hkzlab/CGA_Schematics/README.md

# IBM Colour Graphics Adapter (CGA) Schematics

This is a redrawing in KiCad of the original IBM CGA card schematics.
I intend to use these to help me repair original boards and build a clone.

IBM CGA

Original picture under CC BY-SA 4.0, found [here](https://en.wikipedia.org/wiki/Color_Graphics_Adapter#/media/File:IBM_Color_Graphics_Adapter.jpg)

## WARNING

**Help in double checking** and finding issues is appreciated: you can find the original manual [here](docs/Color_Graphics_Adapter_-_Manual.pdf), 
see pages 32-37.

I used this schematic with kicad to build a clone (CGA Redux), which apparently works fine.
