hkzlab/CGA_Schematics/ISA_CGA.pdf

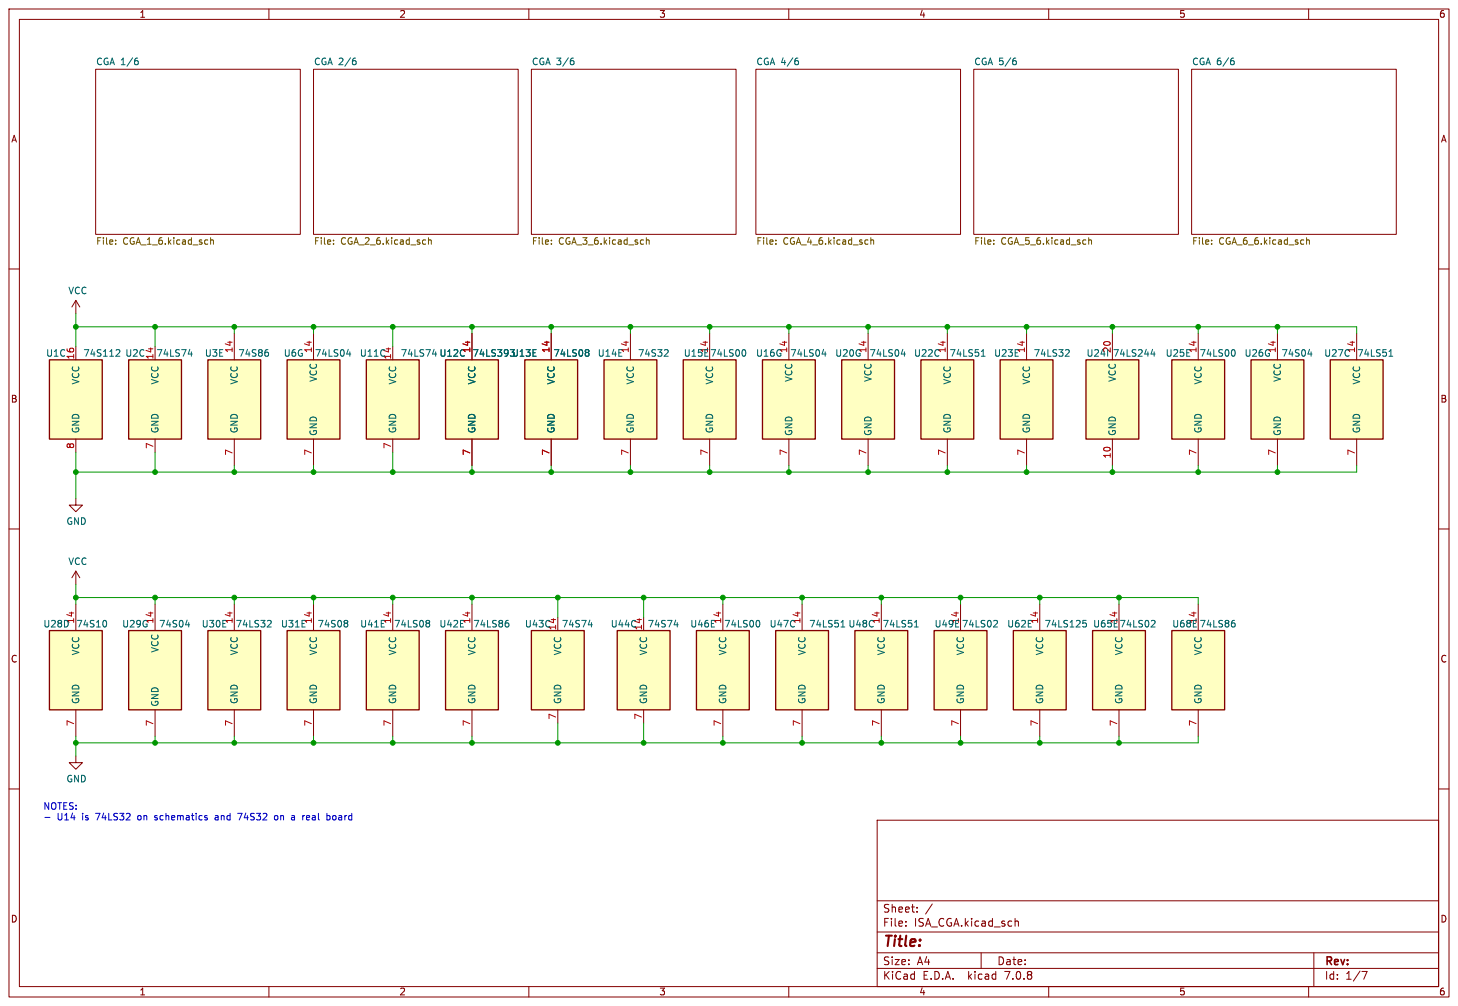
[picture p1: page 1]

7 U25E 74LS00 GND 10 VCC 20 U24I 74LS244 VCC 14 GND

7 U42E 74LS86 NOTES: - U14 is 74LS32 on schematics and 74S32 on a real board

Id: 1/7 Title: File: ISA_CGA.kicad_sch Sheet: /

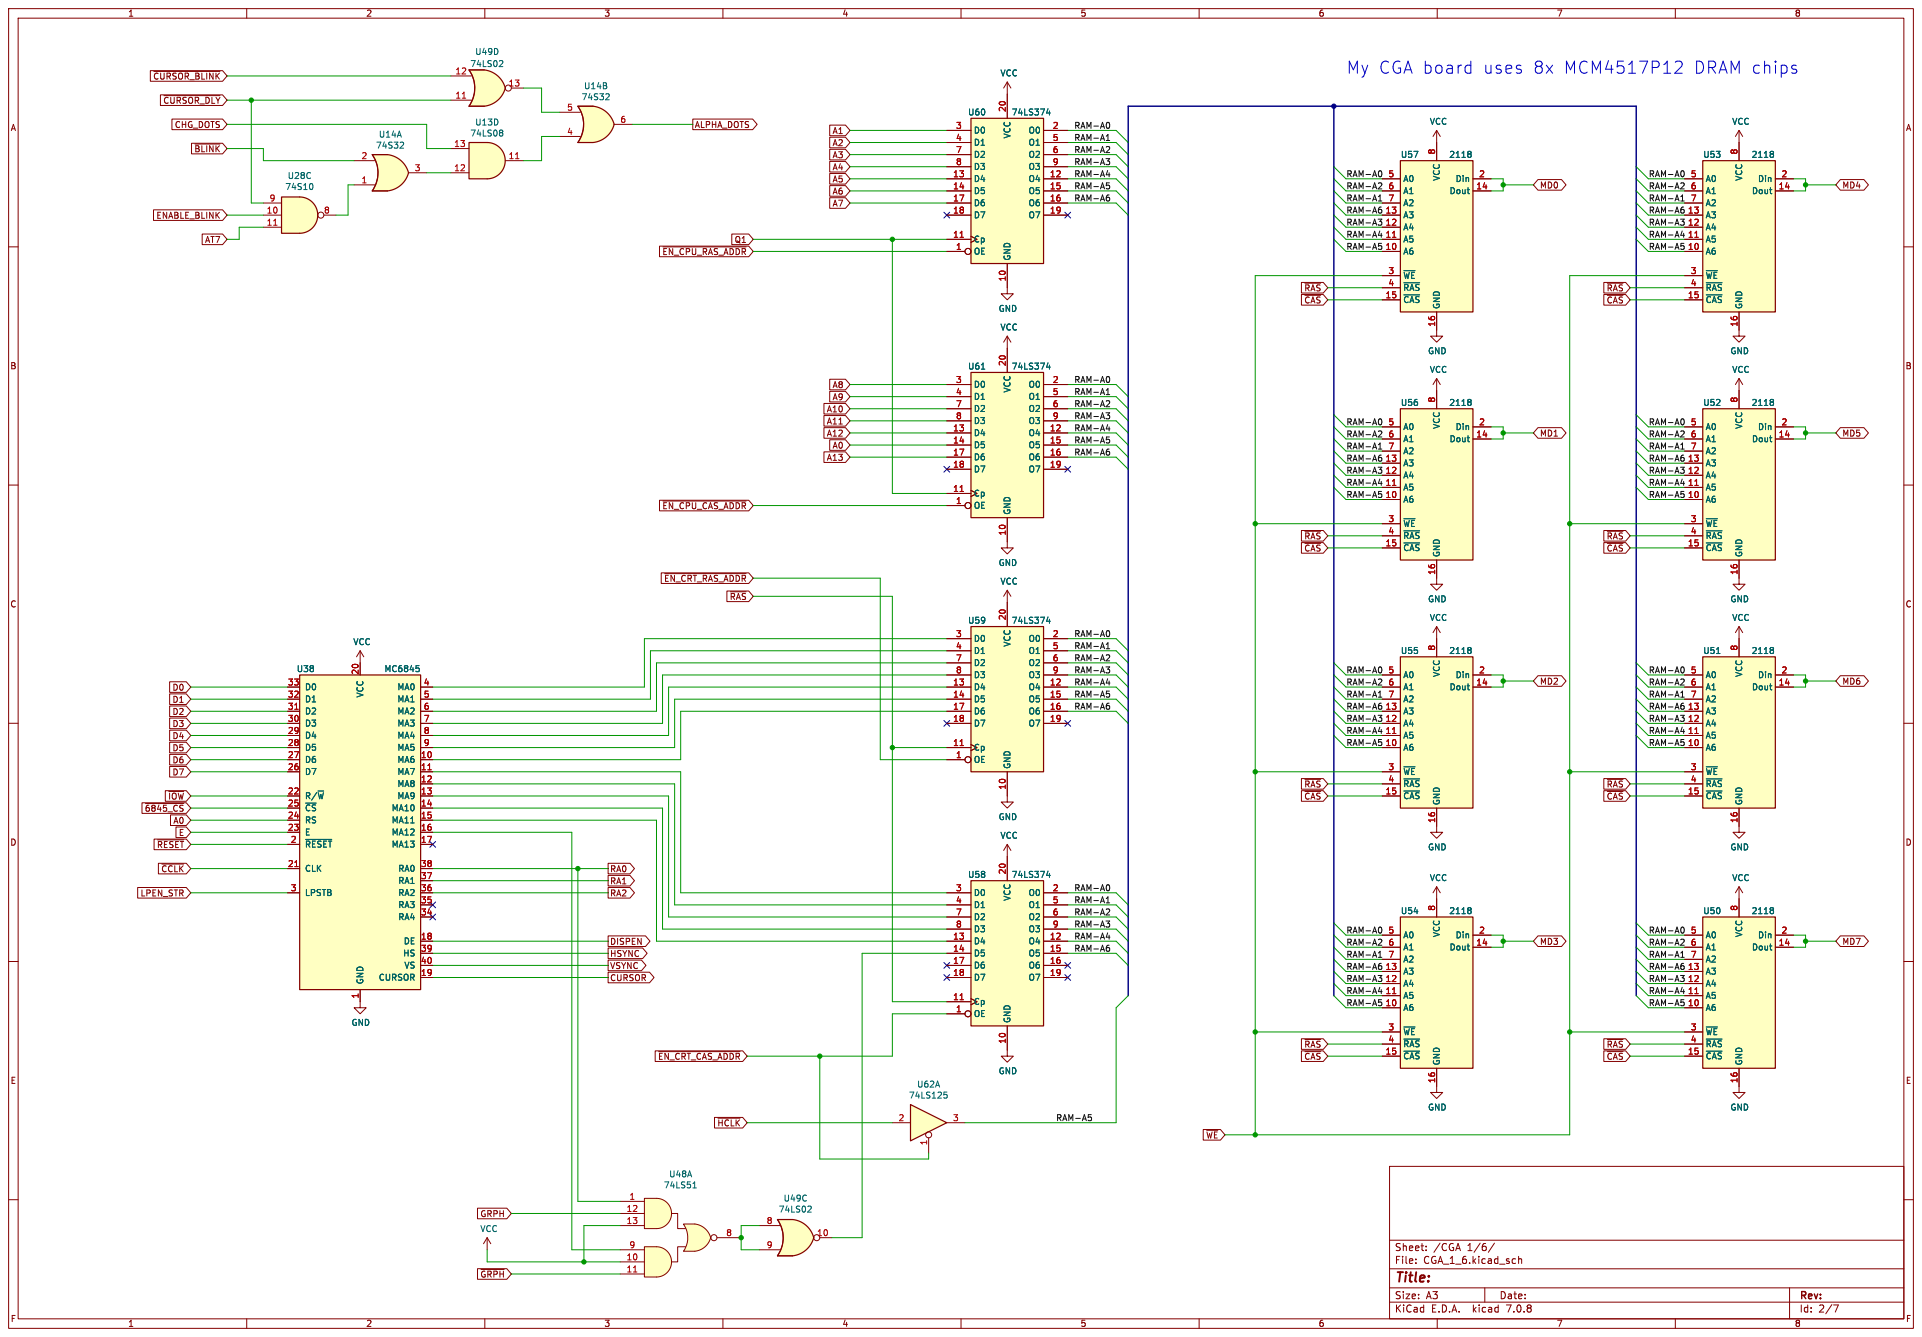
[picture p2: page 2]

RAM-A0 RAM-A2 RAM-A5 RAM-A4

RAM-A3 RAM-A4 RAM-A1 RAM-A6 RAM-A0 RAM-A3

Id: 2/7 Title: File: CGA_1_6.kicad_sch Sheet: /CGA 1/6/

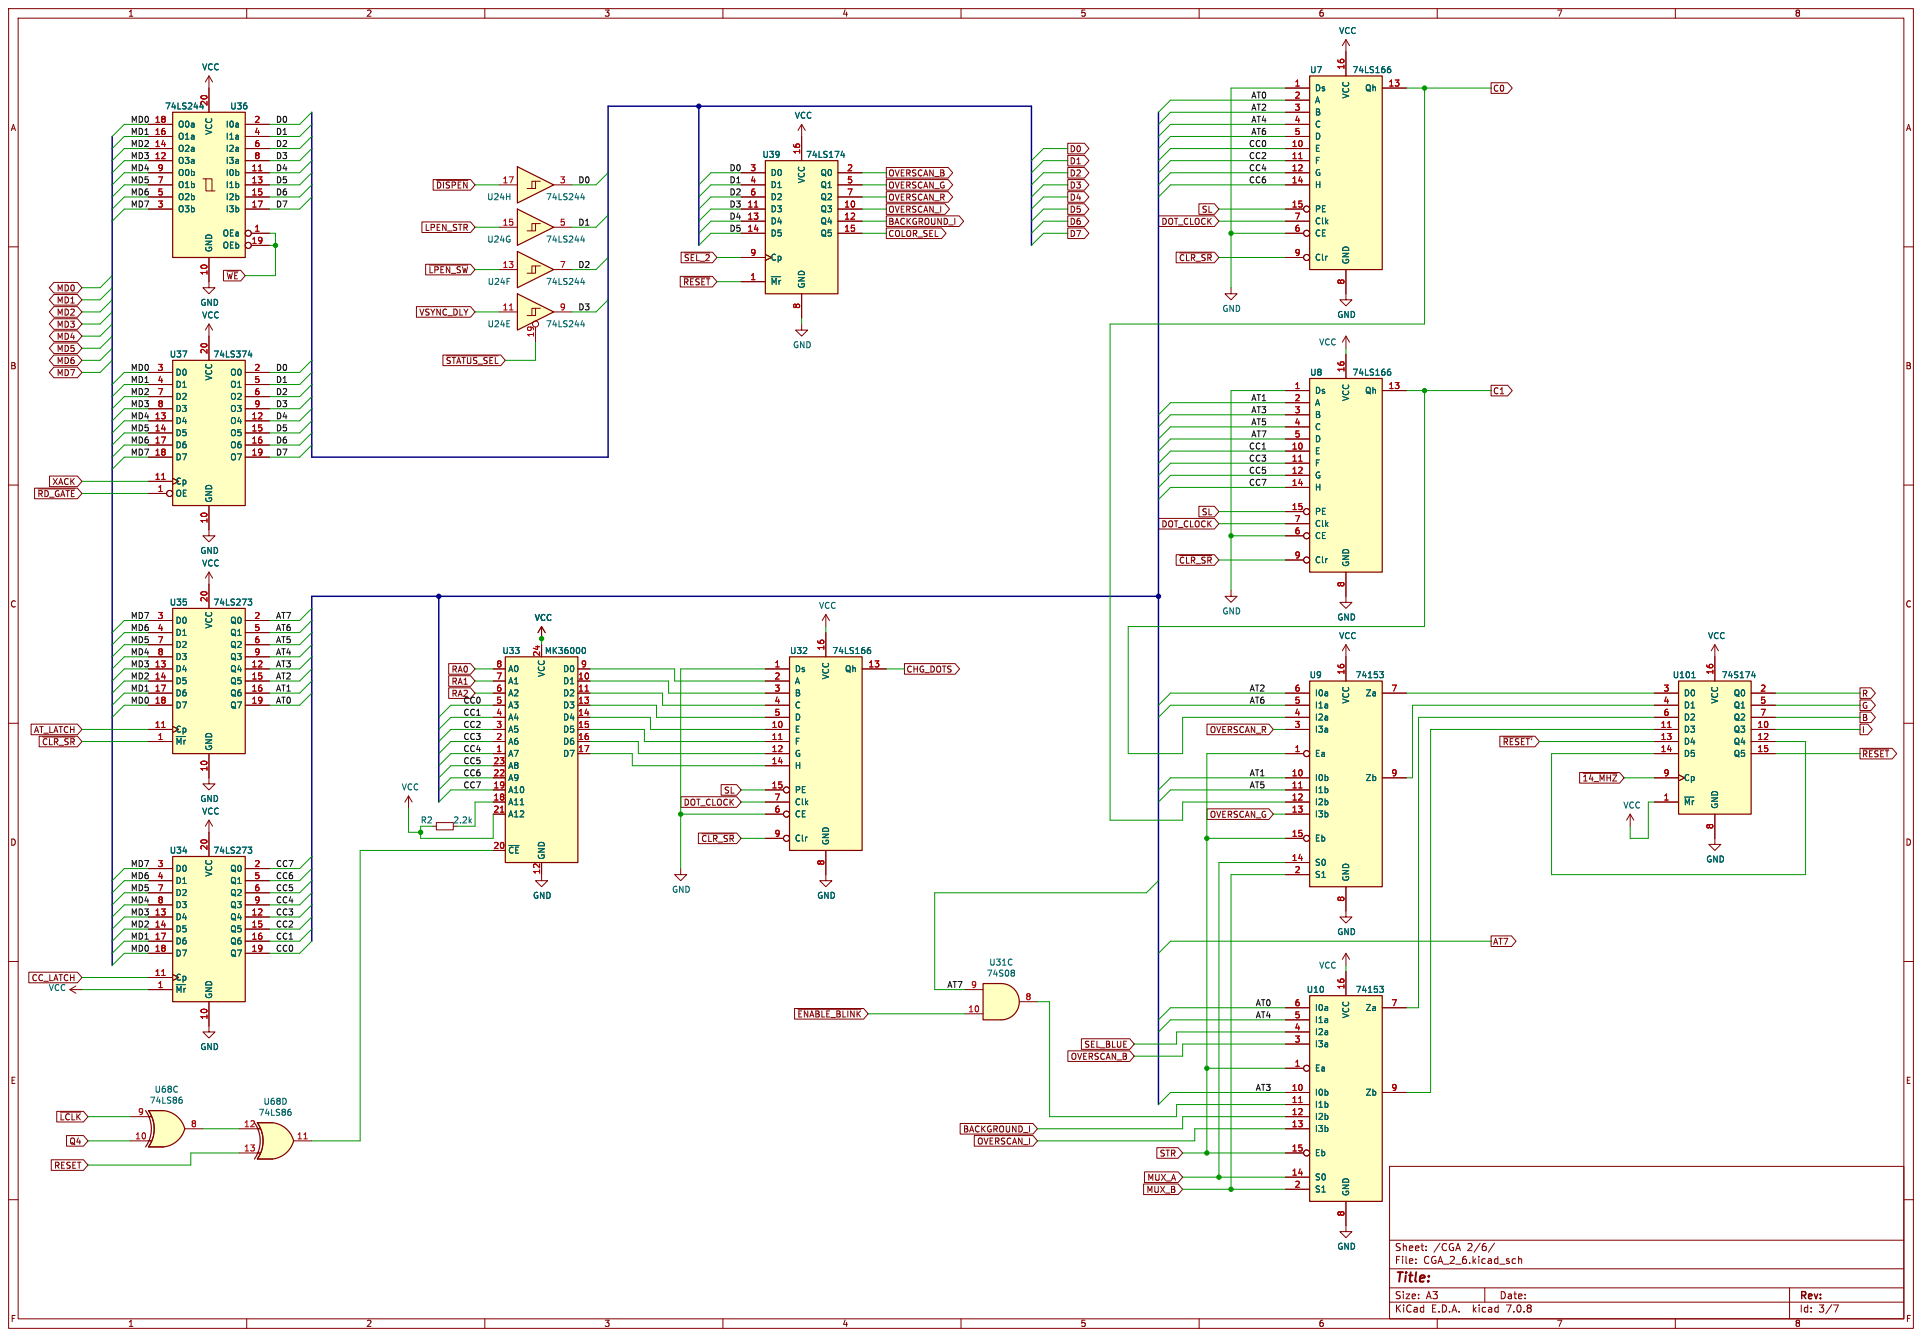
[picture p3: page 3]

Id: 3/7 Title: File: CGA_2_6.kicad_sch Sheet: /CGA 2/6/

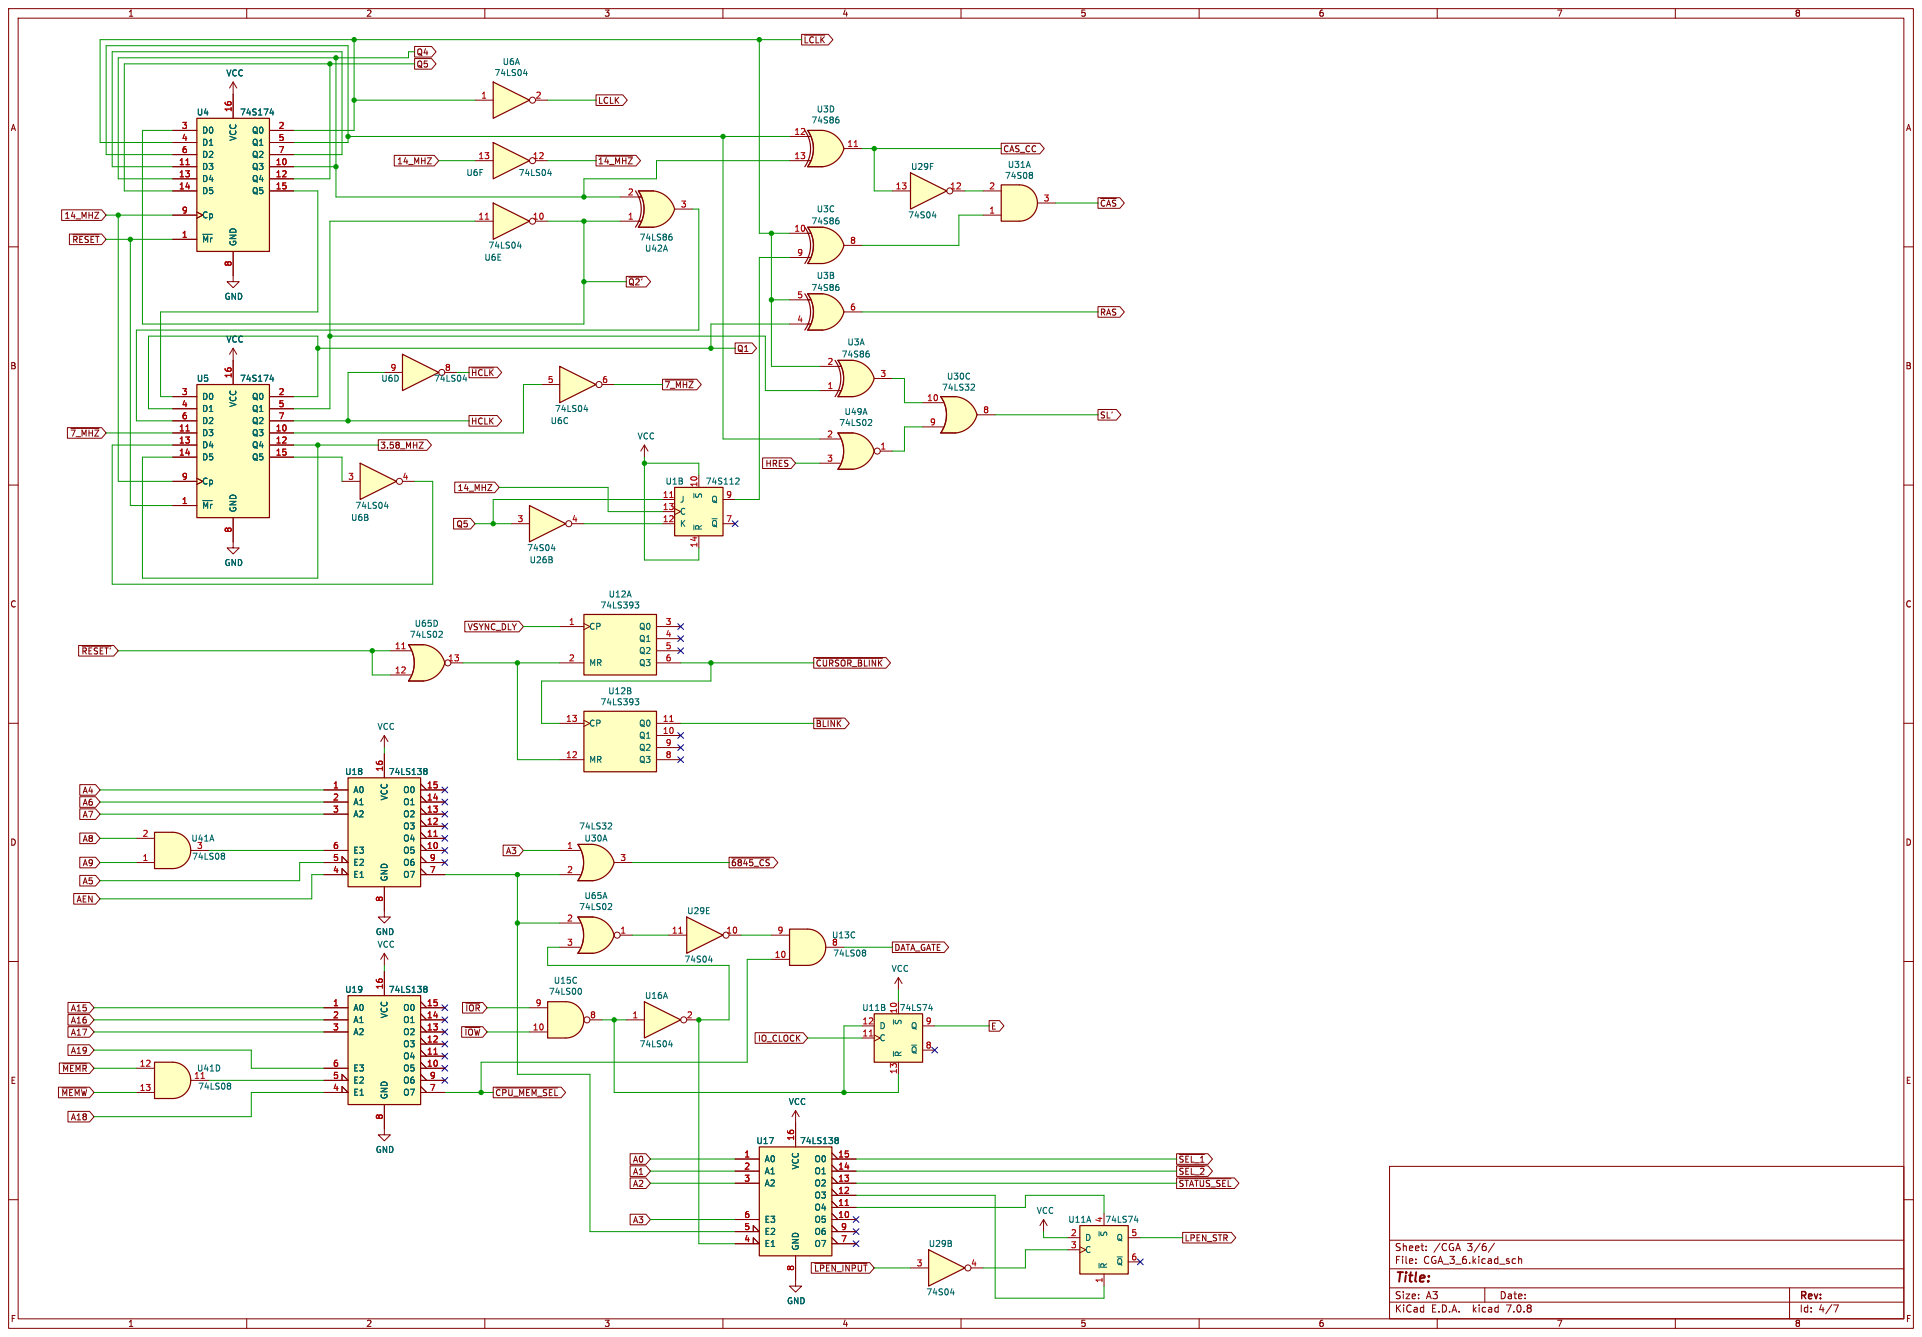
[picture p4: page 4]

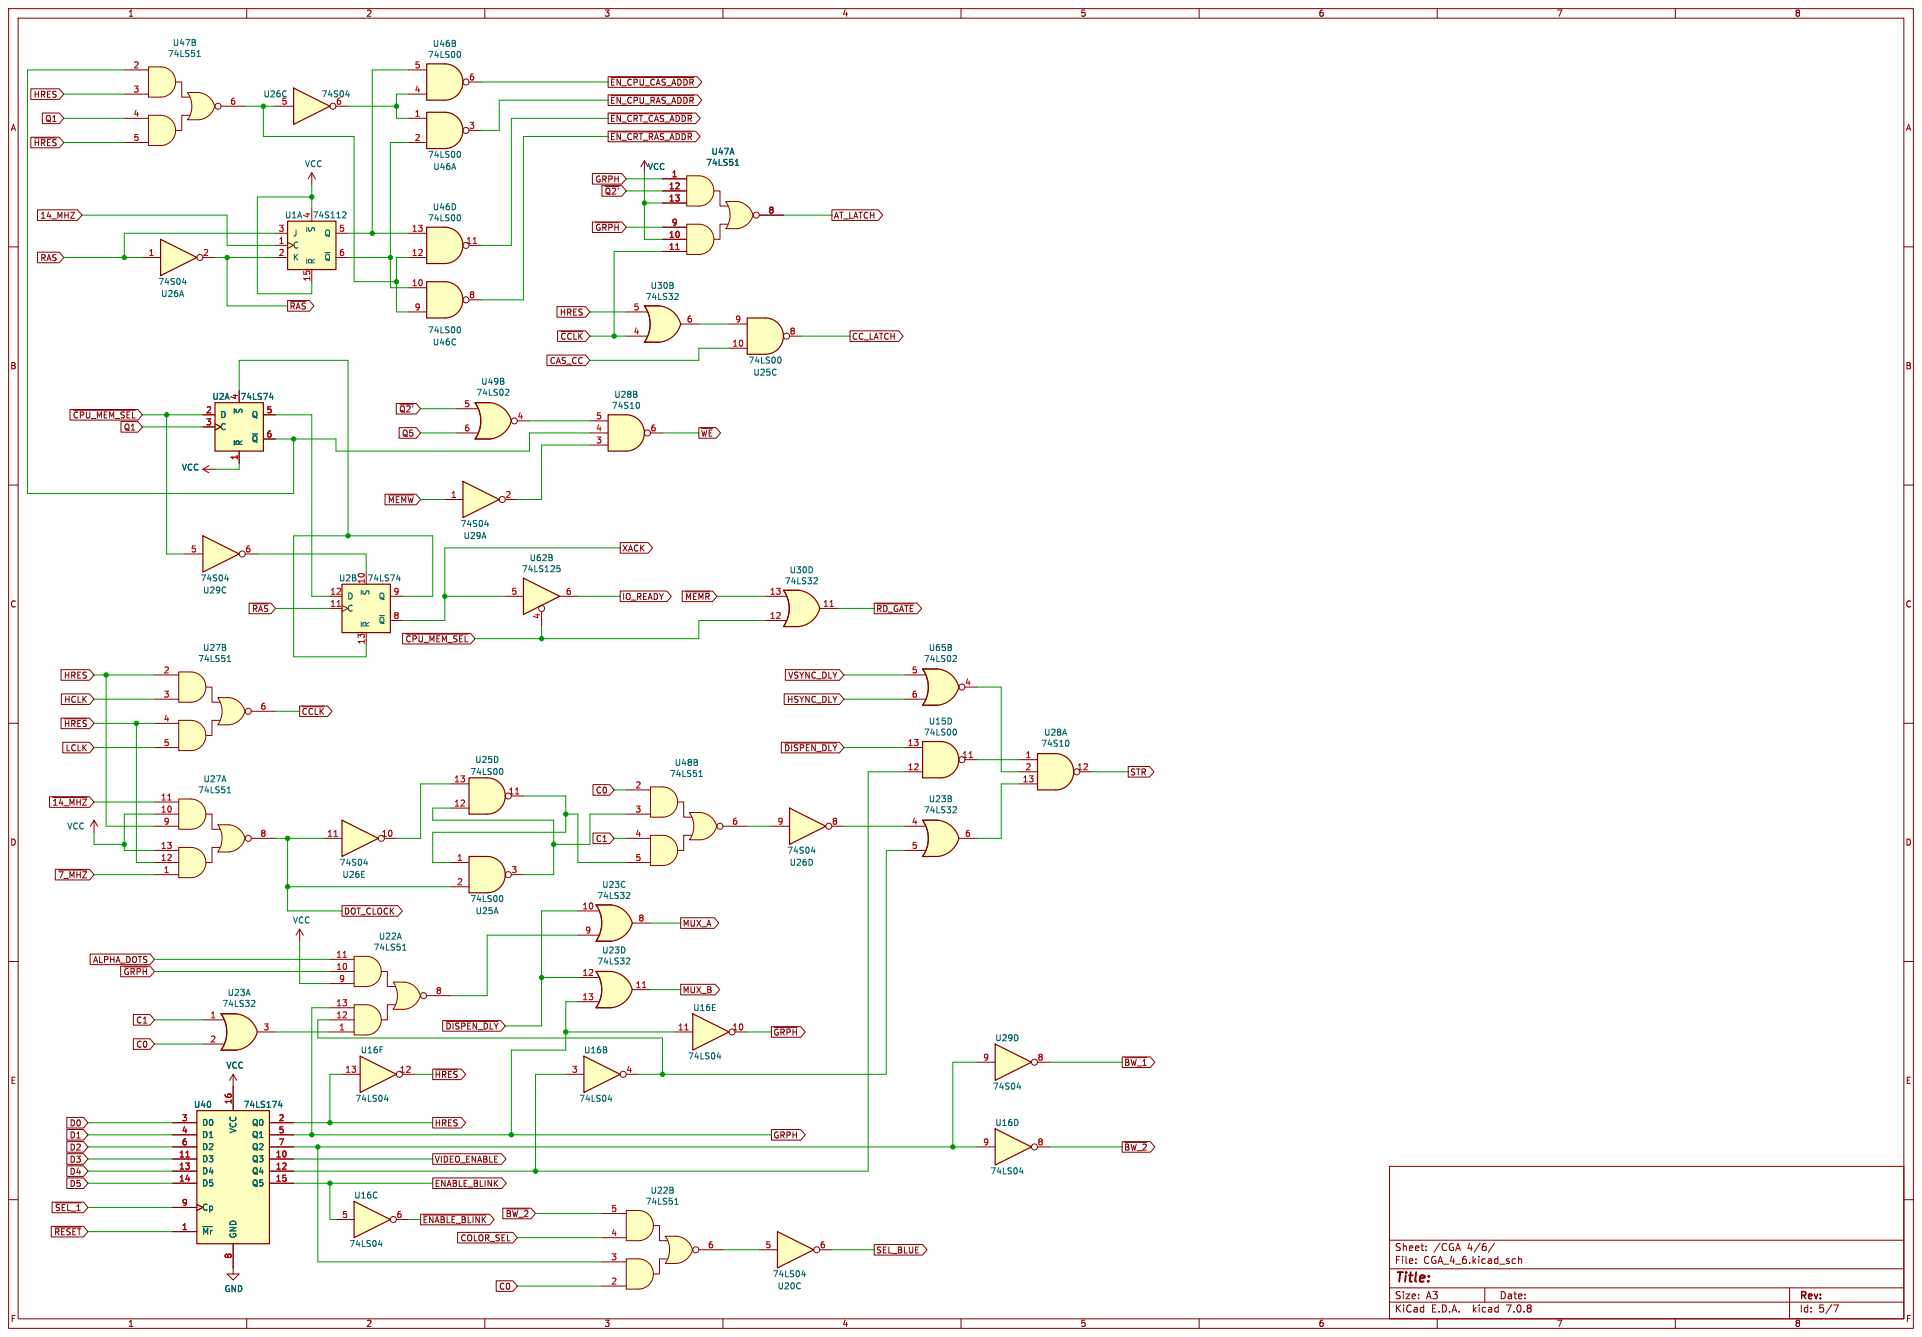
[picture p5: page 5]

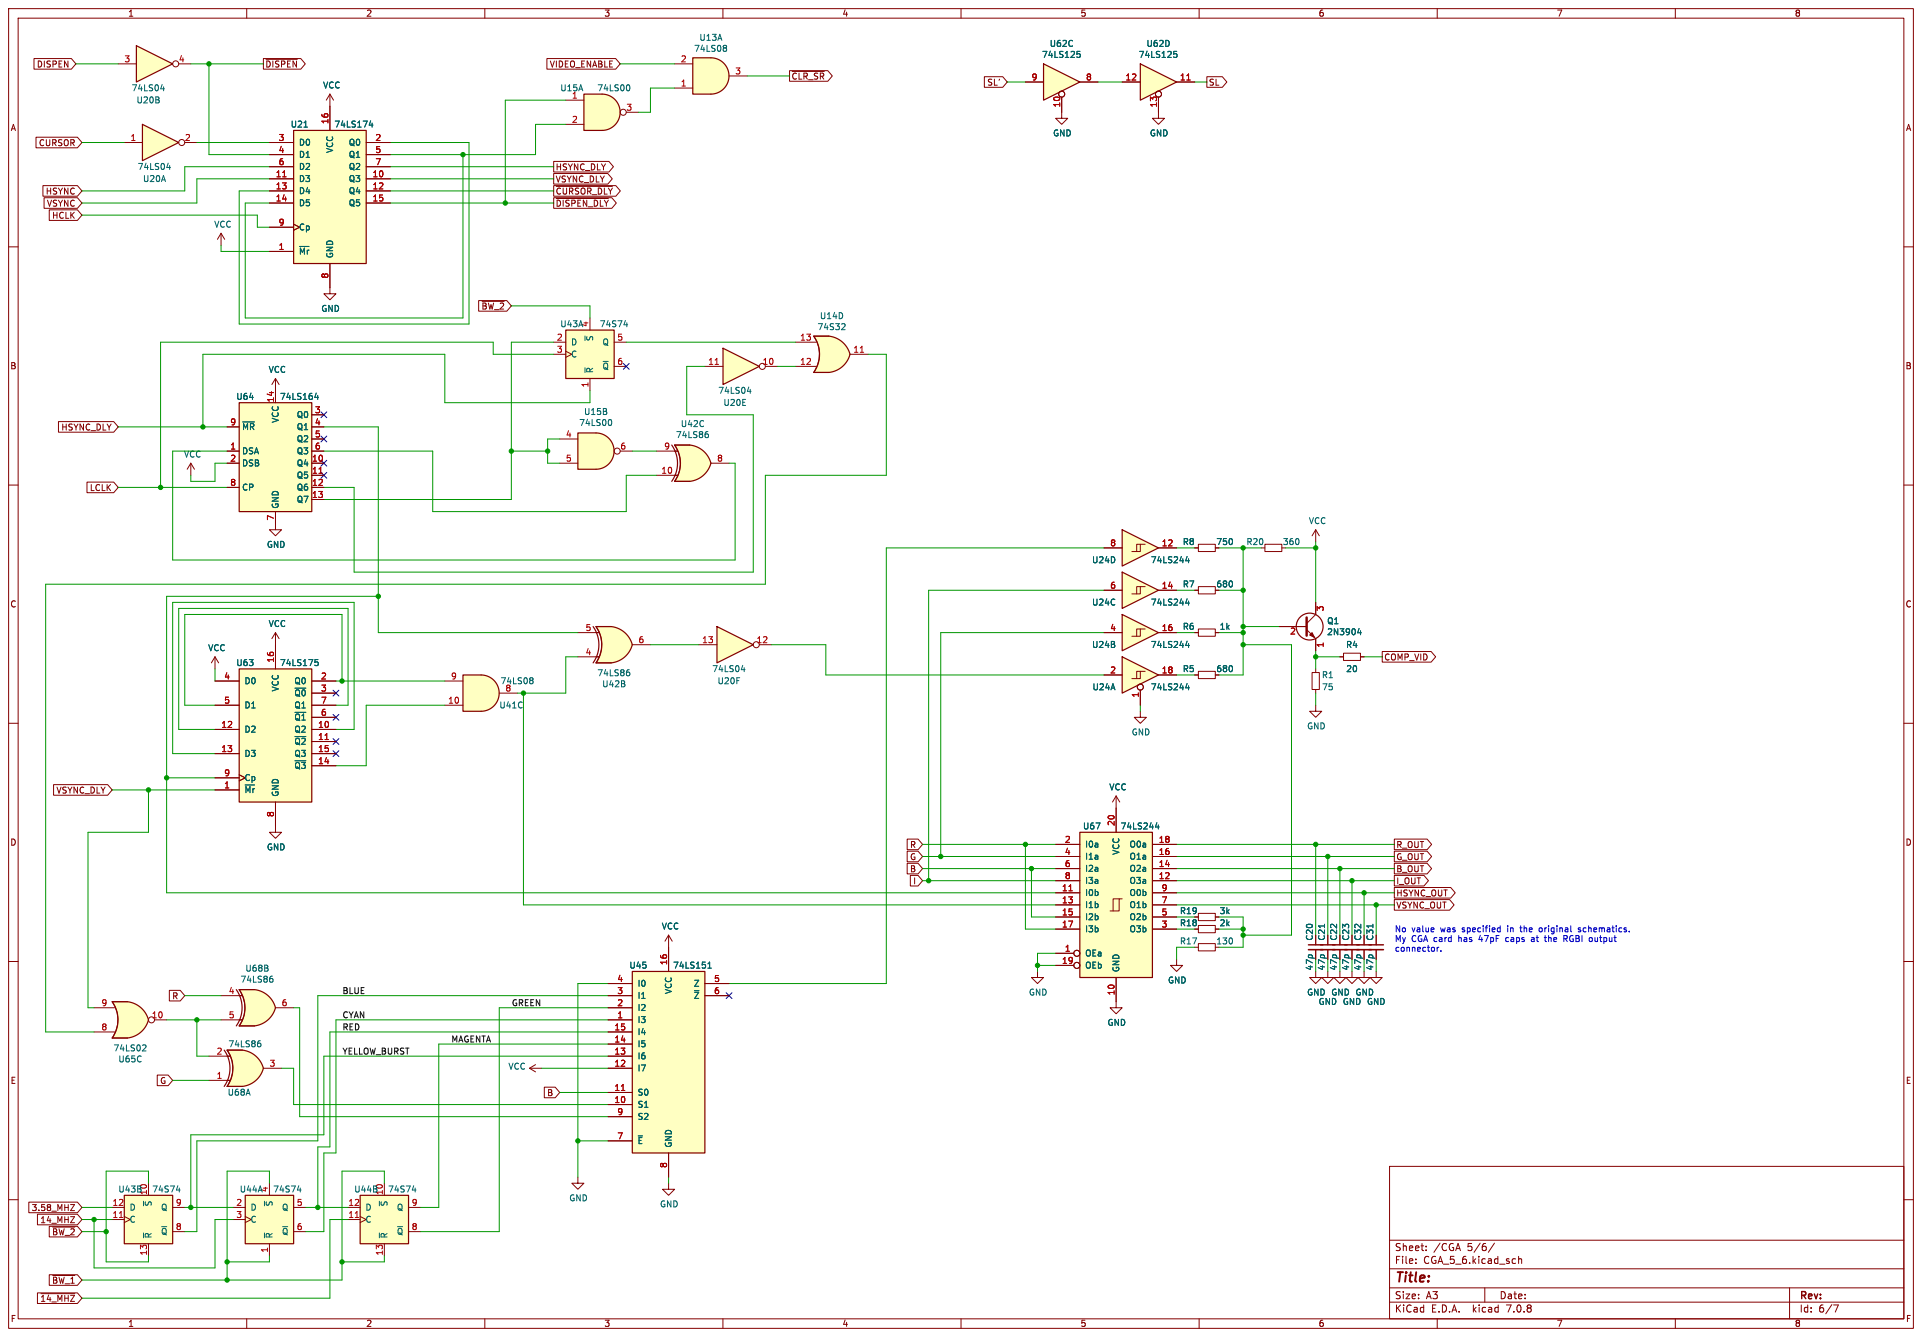
[picture p6: page 6]

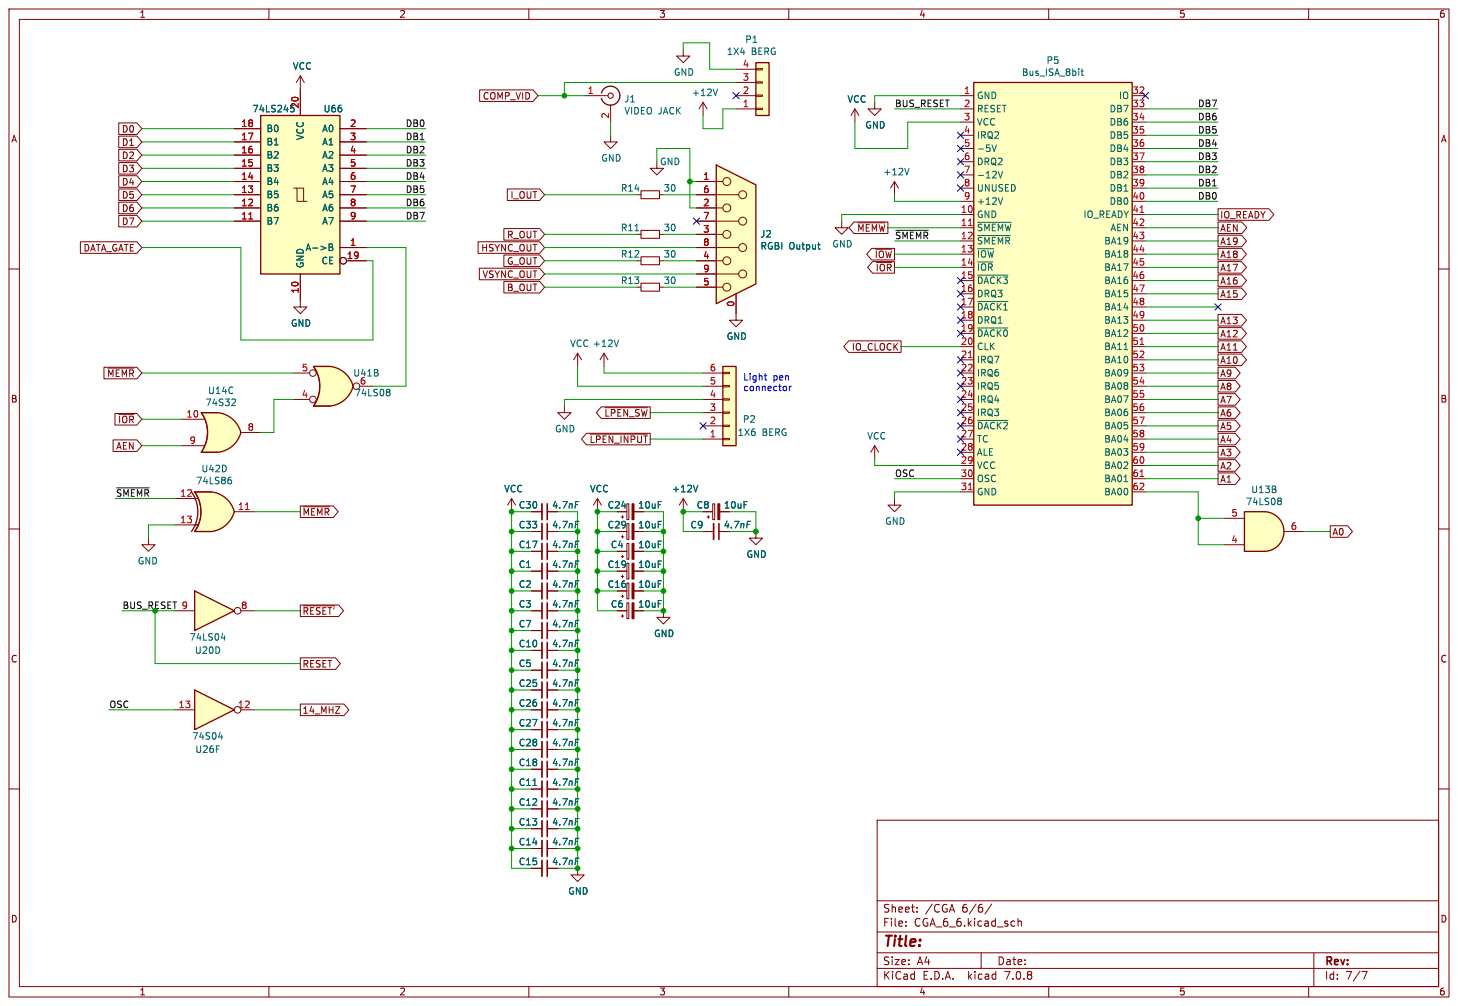
[picture p7: page 7]

Id: 7/7 Title: File: CGA_6_6.kicad_sch Sheet: /CGA 6/6/
