hkzlab/CGA_Schematics/CGA_1_6.kicad_sch

## KiCad design CGA_1_6.kicad_sch (2023-10-13)

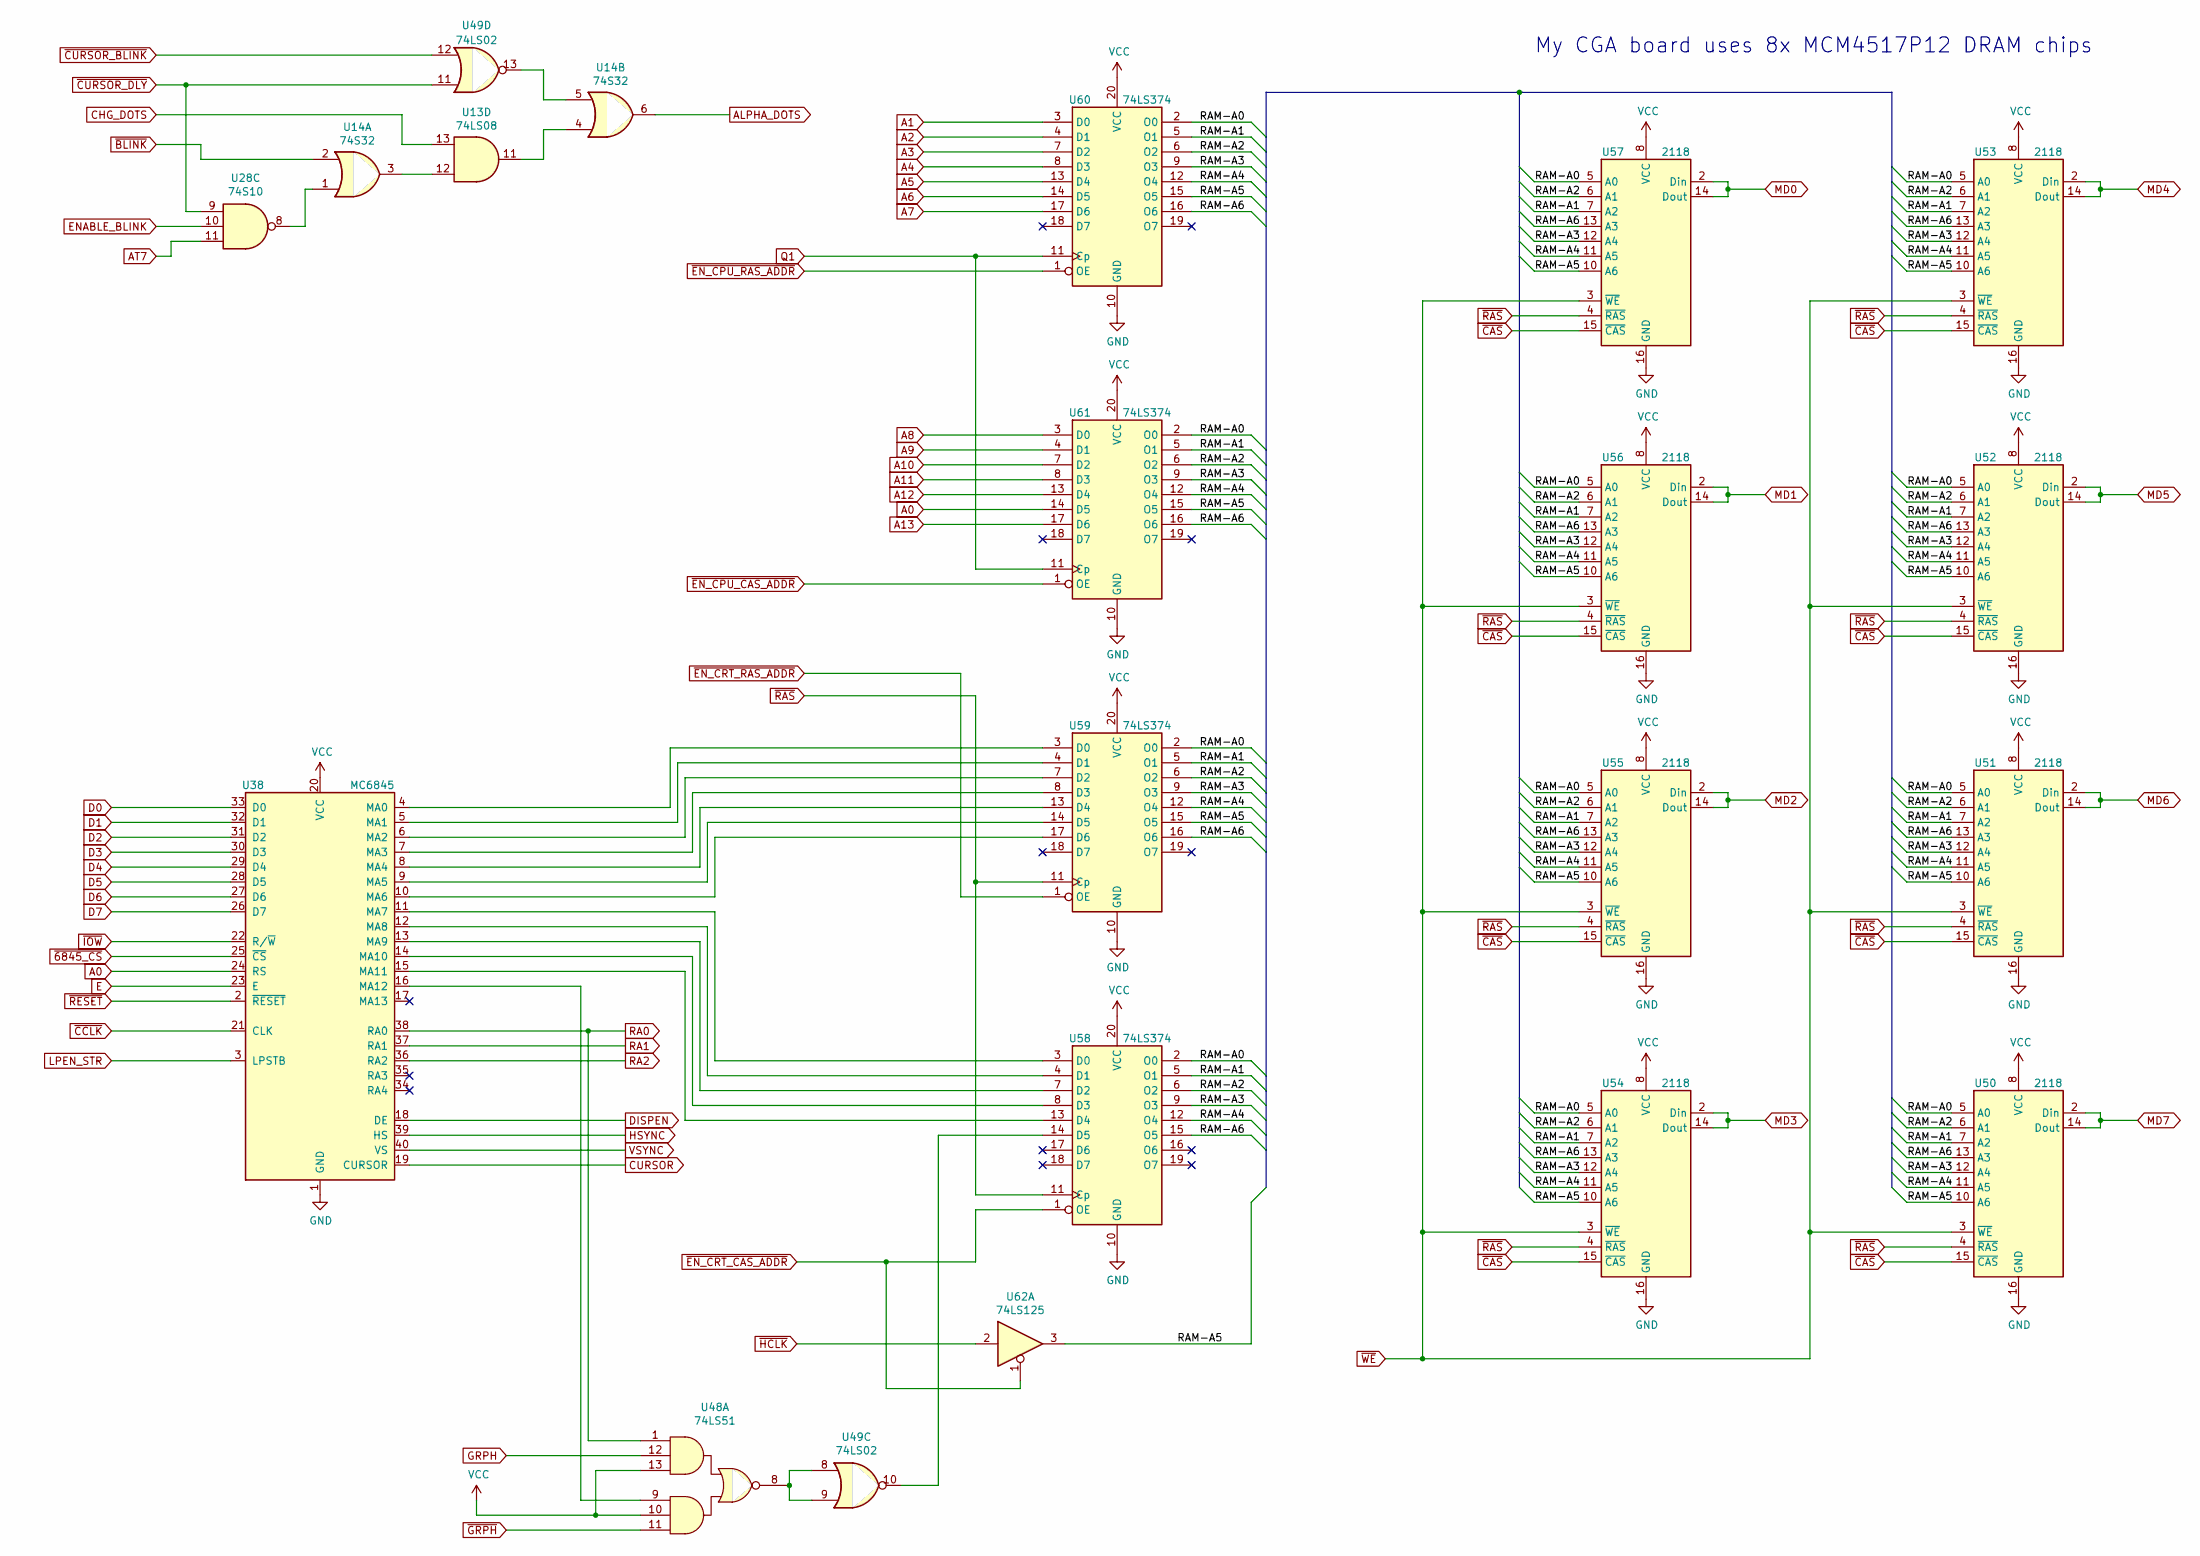
[picture p8: schematic CGA_1_6.kicad_sch]

Parts:
U13: 74LS08; DIP-14_W7.62mm_LongPads
U14: 74S32; DIP-14_W7.62mm_LongPads
U28: 74S10; DIP-14_W7.62mm_LongPads
U38: MC6845; DIP-40_W15.24mm_LongPads
U48: 74LS51; DIP-14_W7.62mm_LongPads
U49: 74LS02
U50, U51, U52, U53, U54, U55, U56, U57: 2118; DIP-16_W7.62mm_LongPads
U58, U59, U60, U61: 74LS374; DIP-20_W7.62mm_LongPads
U62: 74LS125; DIP-14_W7.62mm_LongPads

Connections:
A0: U38.24 (RS), U61.14 (D5)
A1: U60.3 (D0)
A2: U60.4 (D1)
A3: U60.7 (D2)
A4: U60.8 (D3)
A5: U60.13 (D4)
A6: U60.14 (D5)
A7: U60.17 (D6)
A8: U61.3 (D0)
A9: U61.4 (D1)
A10: U61.7 (D2)
A11: U61.8 (D3)
A12: U61.13 (D4)
A13: U61.17 (D6)
ALPHA_DOTS: U14.6
AT7: U28.11
CHG_DOTS: U13.13
CURSOR: U38.19 (CURSOR)
D0: U38.33 (D0)
D1: U38.32 (D1)
D2: U38.31 (D2)
D3: U38.30 (D3)
D4: U38.29 (D4)
D5: U38.28 (D5)
D6: U38.27 (D6)
D7: U38.26 (D7)
DISPEN: U38.18 (DE)
E: U38.23 (E)
ENABLE_BLINK: U28.10
GND: U38.1 (GND), U50.16 (GND), U51.16 (GND), U52.16 (GND), U53.16 (GND), U54.16 (GND), U55.16 (GND), U56.16 (GND), U57.16 (GND), U58.10 (GND), U59.10 (GND), U60.10 (GND), U61.10 (GND)
GRPH: U48.12
HSYNC: U38.39 (HS)
LPEN_STR: U38.3 (LPSTB)
MD0: U57.2 (Din), U57.14 (Dout)
MD1: U56.2 (Din), U56.14 (Dout)
MD2: U55.2 (Din), U55.14 (Dout)
MD3: U54.2 (Din), U54.14 (Dout)
MD4: U53.2 (Din), U53.14 (Dout)
MD5: U52.2 (Din), U52.14 (Dout)
MD6: U51.2 (Din), U51.14 (Dout)
MD7: U50.2 (Din), U50.14 (Dout)
unnamed: U13.11, U14.4
unnamed: U13.12, U14.3
unnamed: U14.1, U28.8
unnamed: U14.5, U49.13
unnamed: U38.4 (MA0), U59.3 (D0)
unnamed: U38.5 (MA1), U59.4 (D1)
unnamed: U38.6 (MA2), U59.7 (D2)
unnamed: U38.7 (MA3), U59.8 (D3)
unnamed: U38.8 (MA4), U59.13 (D4)
unnamed: U38.9 (MA5), U59.14 (D5)
unnamed: U38.10 (MA6), U59.17 (D6)
unnamed: U38.11 (MA7), U58.3 (D0)
unnamed: U38.12 (MA8), U58.4 (D1)
unnamed: U38.13 (MA9), U58.7 (D2)
unnamed: U38.14 (MA10), U58.8 (D3)
unnamed: U38.15 (MA11), U58.13 (D4)
unnamed: U38.16 (MA12), U48.9
unnamed: U48.8, U49.8, U49.9
unnamed: U49.10, U58.14 (D5)
Q1: U60.11 (Cp), U61.11 (Cp)
RA0: U38.38 (RA0), U48.1
RA1: U38.37 (RA1)
RA2: U38.36 (RA2)
RAM-A0: U50.5 (A0), U51.5 (A0), U52.5 (A0), U53.5 (A0), U54.5 (A0), U55.5 (A0), U56.5 (A0), U57.5 (A0), U58.2 (O0), U59.2 (O0), U60.2 (O0), U61.2 (O0)
RAM-A1: U50.7 (A2), U51.7 (A2), U52.7 (A2), U53.7 (A2), U54.7 (A2), U55.7 (A2), U56.7 (A2), U57.7 (A2), U58.5 (O1), U59.5 (O1), U60.5 (O1), U61.5 (O1)
RAM-A2: U50.6 (A1), U51.6 (A1), U52.6 (A1), U53.6 (A1), U54.6 (A1), U55.6 (A1), U56.6 (A1), U57.6 (A1), U58.6 (O2), U59.6 (O2), U60.6 (O2), U61.6 (O2)
RAM-A3: U50.12 (A4), U51.12 (A4), U52.12 (A4), U53.12 (A4), U54.12 (A4), U55.12 (A4), U56.12 (A4), U57.12 (A4), U58.9 (O3), U59.9 (O3), U60.9 (O3), U61.9 (O3)
RAM-A4: U50.11 (A5), U51.11 (A5), U52.11 (A5), U53.11 (A5), U54.11 (A5), U55.11 (A5), U56.11 (A5), U57.11 (A5), U58.12 (O4), U59.12 (O4), U60.12 (O4), U61.12 (O4)
RAM-A5: U50.10 (A6), U51.10 (A6), U52.10 (A6), U53.10 (A6), U54.10 (A6), U55.10 (A6), U56.10 (A6), U57.10 (A6), U59.15 (O5), U60.15 (O5), U61.15 (O5), U62.3
RAM-A6: U50.13 (A3), U51.13 (A3), U52.13 (A3), U53.13 (A3), U54.13 (A3), U55.13 (A3), U56.13 (A3), U57.13 (A3), U58.15 (O5), U59.16 (O6), U60.16 (O6), U61.16 (O6)
VCC: U38.20 (VCC), U48.10, U48.13, U50.8 (VCC), U51.8 (VCC), U52.8 (VCC), U53.8 (VCC), U54.8 (VCC), U55.8 (VCC), U56.8 (VCC), U57.8 (VCC), U58.20 (VCC), U59.20 (VCC), U60.20 (VCC), U61.20 (VCC)
VSYNC: U38.40 (VS)
~6845_CS: U38.25 (~CS)
~BLINK: U14.2
~CAS: U50.15 (~CAS), U51.15 (~CAS), U52.15 (~CAS), U53.15 (~CAS), U54.15 (~CAS), U55.15 (~CAS), U56.15 (~CAS), U57.15 (~CAS)
~CCLK: U38.21 (CLK)
~CURSOR_BLINK: U49.12
~CURSOR_DLY: U28.9, U49.11
~EN_CPU_CAS_ADDR: U61.1 (OE)
~EN_CPU_RAS_ADDR: U60.1 (OE)
~EN_CRT_CAS_ADDR: U58.1 (OE), U62.1
~EN_CRT_RAS_ADDR: U59.1 (OE)
~GRPH: U48.11
~HCLK: U62.2
~IOW: U38.22 (R/~W)
~RAS: U50.4 (~RAS), U51.4 (~RAS), U52.4 (~RAS), U53.4 (~RAS), U54.4 (~RAS), U55.4 (~RAS), U56.4 (~RAS), U57.4 (~RAS), U58.11 (Cp), U59.11 (Cp)
~RESET: U38.2 (~RESET)
~WE: U50.3 (~WE), U51.3 (~WE), U52.3 (~WE), U53.3 (~WE), U54.3 (~WE), U55.3 (~WE), U56.3 (~WE), U57.3 (~WE)

Notes on the sheet:
My CGA board uses 8x MCM4517P12 DRAM chips
