hkzlab/CGA_Schematics/CGA_2_6.kicad_sch

## KiCad design CGA_2_6.kicad_sch (2023-10-13)

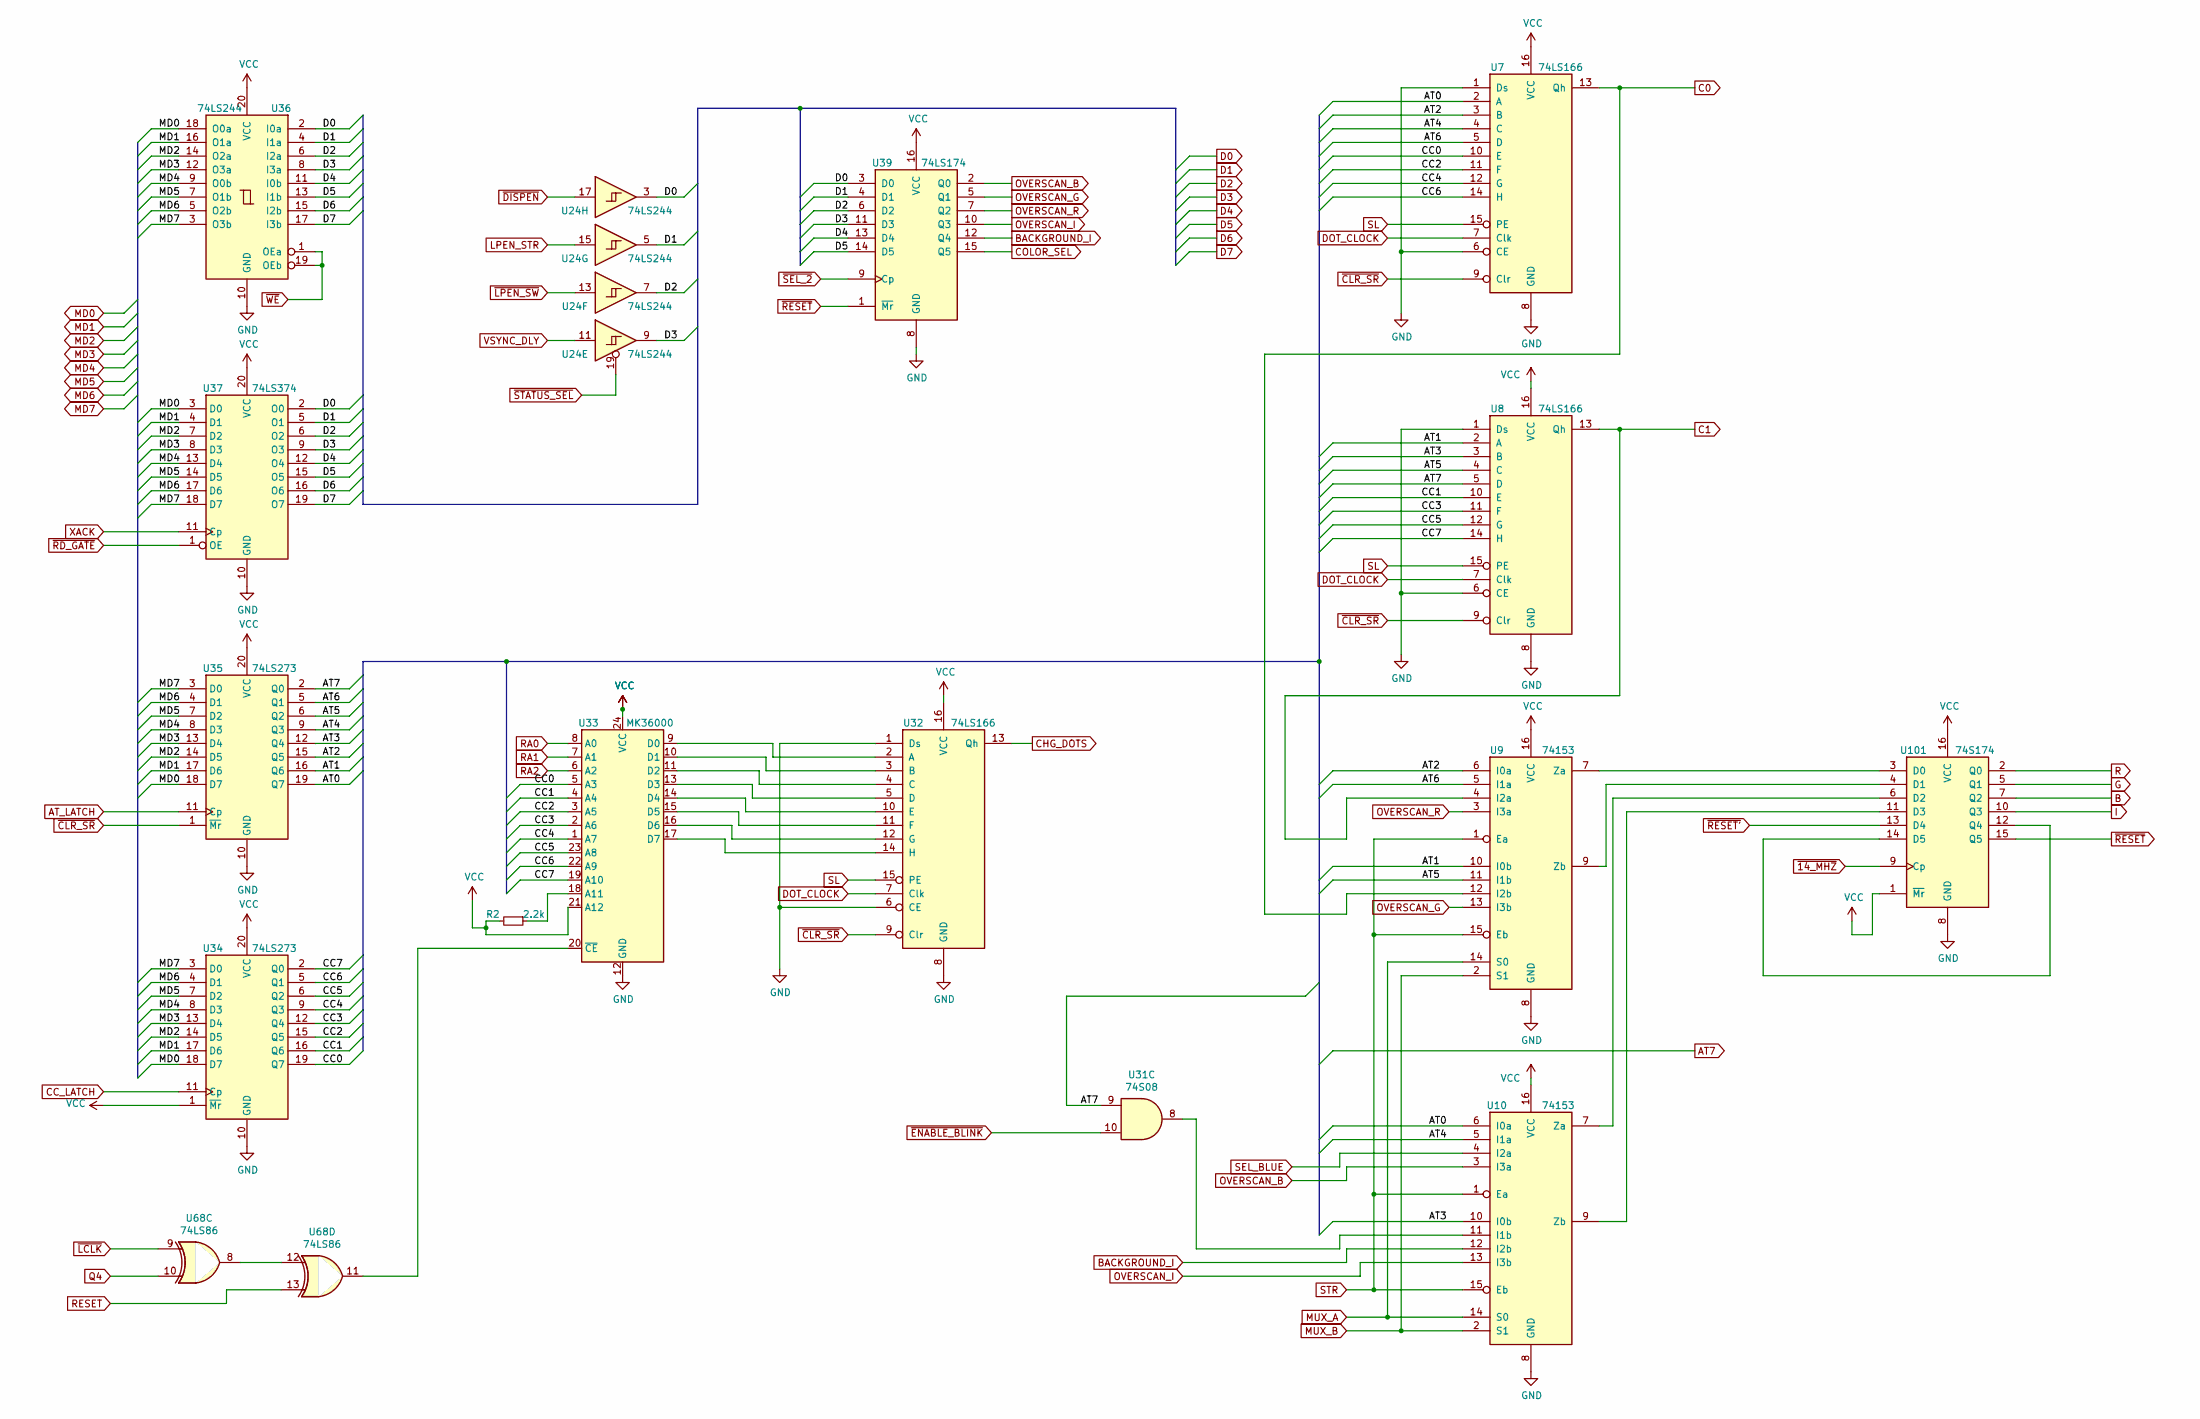
[picture p9: schematic CGA_2_6.kicad_sch]

Parts:
R2: 2.2k; R_Axial_DIN0207_L6.3mm_D2.5mm_P10.16mm_Horizontal
U7, U8, U32: 74LS166; DIP-16_W7.62mm_LongPads
U9, U10: 74153; DIP-16_W7.62mm_LongPads
U24, U36: 74LS244; DIP-20_W7.62mm_LongPads
U31: 74S08; DIP-14_W7.62mm_LongPads
U33: MK36000; DIP-24_W15.24mm_LongPads
U34, U35: 74LS273; DIP-20_W7.62mm_LongPads
U37: 74LS374; DIP-20_W7.62mm_LongPads
U39: 74LS174; DIP-16_W7.62mm_LongPads
U68: 74LS86; DIP-14_W7.62mm_LongPads
U101: 74S174; DIP-16_W7.62mm_LongPads

Connections:
AT0: U7.2 (A), U10.6 (I0a), U35.19 (Q7)
AT1: U8.2 (A), U9.10 (I0b), U35.16 (Q6)
AT2: U7.3 (B), U9.6 (I0a), U35.15 (Q5)
AT3: U8.3 (B), U10.10 (I0b), U35.12 (Q4)
AT4: U7.4 (C), U10.5 (I1a), U35.9 (Q3)
AT5: U8.4 (C), U9.11 (I1b), U35.6 (Q2)
AT6: U7.5 (D), U9.5 (I1a), U35.5 (Q1)
AT7: U8.5 (D), U31.9, U35.2 (Q0)
AT_LATCH: U35.11 (Cp)
B: U101.7 (Q2)
BACKGROUND_I: U10.12 (I2b), U39.12 (Q4)
C0: U7.13 (Qh), U9.12 (I2b)
C1: U8.13 (Qh), U9.4 (I2a)
CC0: U7.10 (E), U33.5 (A3), U34.19 (Q7)
CC1: U8.10 (E), U33.4 (A4), U34.16 (Q6)
CC2: U7.11 (F), U33.3 (A5), U34.15 (Q5)
CC3: U8.11 (F), U33.2 (A6), U34.12 (Q4)
CC4: U7.12 (G), U33.1 (A7), U34.9 (Q3)
CC5: U8.12 (G), U33.23 (A8), U34.6 (Q2)
CC6: U7.14 (H), U33.22 (A9), U34.5 (Q1)
CC7: U8.14 (H), U33.19 (A10), U34.2 (Q0)
CC_LATCH: U34.11 (Cp)
CHG_DOTS: U32.13 (Qh)
COLOR_SEL: U39.15 (Q5)
D0: U24.3, U36.2 (I0a), U37.2 (O0), U39.3 (D0)
D1: U24.5, U36.4 (I1a), U37.5 (O1), U39.4 (D1)
D2: U24.7, U36.6 (I2a), U37.6 (O2), U39.6 (D2)
D3: U24.9, U36.8 (I3a), U37.9 (O3), U39.11 (D3)
D4: U36.11 (I0b), U37.12 (O4), U39.13 (D4)
D5: U36.13 (I1b), U37.15 (O5), U39.14 (D5)
D6: U36.15 (I2b), U37.16 (O6)
D7: U36.17 (I3b), U37.19 (O7)
DOT_CLOCK: U7.7 (Clk), U8.7 (Clk), U32.7 (Clk)
G: U101.5 (Q1)
GND: U7.1 (Ds), U7.6 (CE), U7.8 (GND), U8.1 (Ds), U8.6 (CE), U8.8 (GND), U9.8 (GND), U10.8 (GND), U32.1 (Ds), U32.6 (CE), U32.8 (GND), U33.12 (GND), U34.10 (GND), U35.10 (GND), U36.10 (GND), U37.10 (GND), U39.8 (GND), U101.8 (GND)
I: U101.10 (Q3)
LPEN_STR: U24.15
MD0: U34.18 (D7), U35.18 (D7), U36.18 (O0a), U37.3 (D0)
MD1: U34.17 (D6), U35.17 (D6), U36.16 (O1a), U37.4 (D1)
MD2: U34.14 (D5), U35.14 (D5), U36.14 (O2a), U37.7 (D2)
MD3: U34.13 (D4), U35.13 (D4), U36.12 (O3a), U37.8 (D3)
MD4: U34.8 (D3), U35.8 (D3), U36.9 (O0b), U37.13 (D4)
MD5: U34.7 (D2), U35.7 (D2), U36.7 (O1b), U37.14 (D5)
MD6: U34.4 (D1), U35.4 (D1), U36.5 (O2b), U37.17 (D6)
MD7: U34.3 (D0), U35.3 (D0), U36.3 (O3b), U37.18 (D7)
MUX_A: U9.14 (S0), U10.14 (S0)
MUX_B: U9.2 (S1), U10.2 (S1)
unnamed: R2.1, U33.18 (A11)
unnamed: U10.7 (Za), U101.6 (D2)
unnamed: U10.9 (Zb), U101.11 (D3)
unnamed: U10.11 (I1b), U31.8
unnamed: U32.2 (A), U33.9 (D0)
unnamed: U32.3 (B), U33.10 (D1)
unnamed: U32.4 (C), U33.11 (D2)
unnamed: U32.5 (D), U33.13 (D3)
unnamed: U32.10 (E), U33.14 (D4)
unnamed: U32.11 (F), U33.15 (D5)
unnamed: U32.12 (G), U33.16 (D6)
unnamed: U32.14 (H), U33.17 (D7)
unnamed: U33.20 (~CE), U68.11
unnamed: U68.8, U68.12
unnamed: U9.7 (Za), U101.3 (D0)
unnamed: U9.9 (Zb), U101.4 (D1)
unnamed: U101.12 (Q4), U101.14 (D5)
OVERSCAN_B: U10.3 (I3a), U39.2 (Q0)
OVERSCAN_G: U9.13 (I3b), U39.5 (Q1)
OVERSCAN_I: U10.13 (I3b), U39.10 (Q3)
OVERSCAN_R: U9.3 (I3a), U39.7 (Q2)
Q4: U68.10
R: U101.2 (Q0)
RA0: U33.8 (A0)
RA1: U33.7 (A1)
RA2: U33.6 (A2)
RESET: U68.13
SEL_BLUE: U10.4 (I2a)
SL: U7.15 (PE), U8.15 (PE), U32.15 (PE)
STR: U9.1 (Ea), U9.15 (Eb), U10.1 (Ea), U10.15 (Eb)
VCC: R2.2, U7.16 (VCC), U8.16 (VCC), U9.16 (VCC), U10.16 (VCC), U32.16 (VCC), U33.21 (A12), U33.24 (VCC), U34.1 (~Mr), U34.20 (VCC), U35.20 (VCC), U36.20 (VCC), U37.20 (VCC), U39.16 (VCC), U101.1 (~Mr), U101.16 (VCC)
VSYNC_DLY: U24.11
XACK: U37.11 (Cp)
~14_MHZ: U101.9 (Cp)
~CLR_SR: U7.9 (Clr), U8.9 (Clr), U32.9 (Clr), U35.1 (~Mr)
~DISPEN: U24.17
~ENABLE_BLINK: U31.10
~LCLK: U68.9
~LPEN_SW: U24.13
~RD_GATE: U37.1 (OE)
~RESET': U101.13 (D4)
~RESET: U39.1 (~Mr), U101.15 (Q5)
~SEL_2: U39.9 (Cp)
~STATUS_SEL: U24.19
~WE: U36.1 (OEa), U36.19 (OEb)
