hkzlab/CGA_Schematics/CGA_3_6.kicad_sch

## KiCad design CGA_3_6.kicad_sch (2023-10-13)

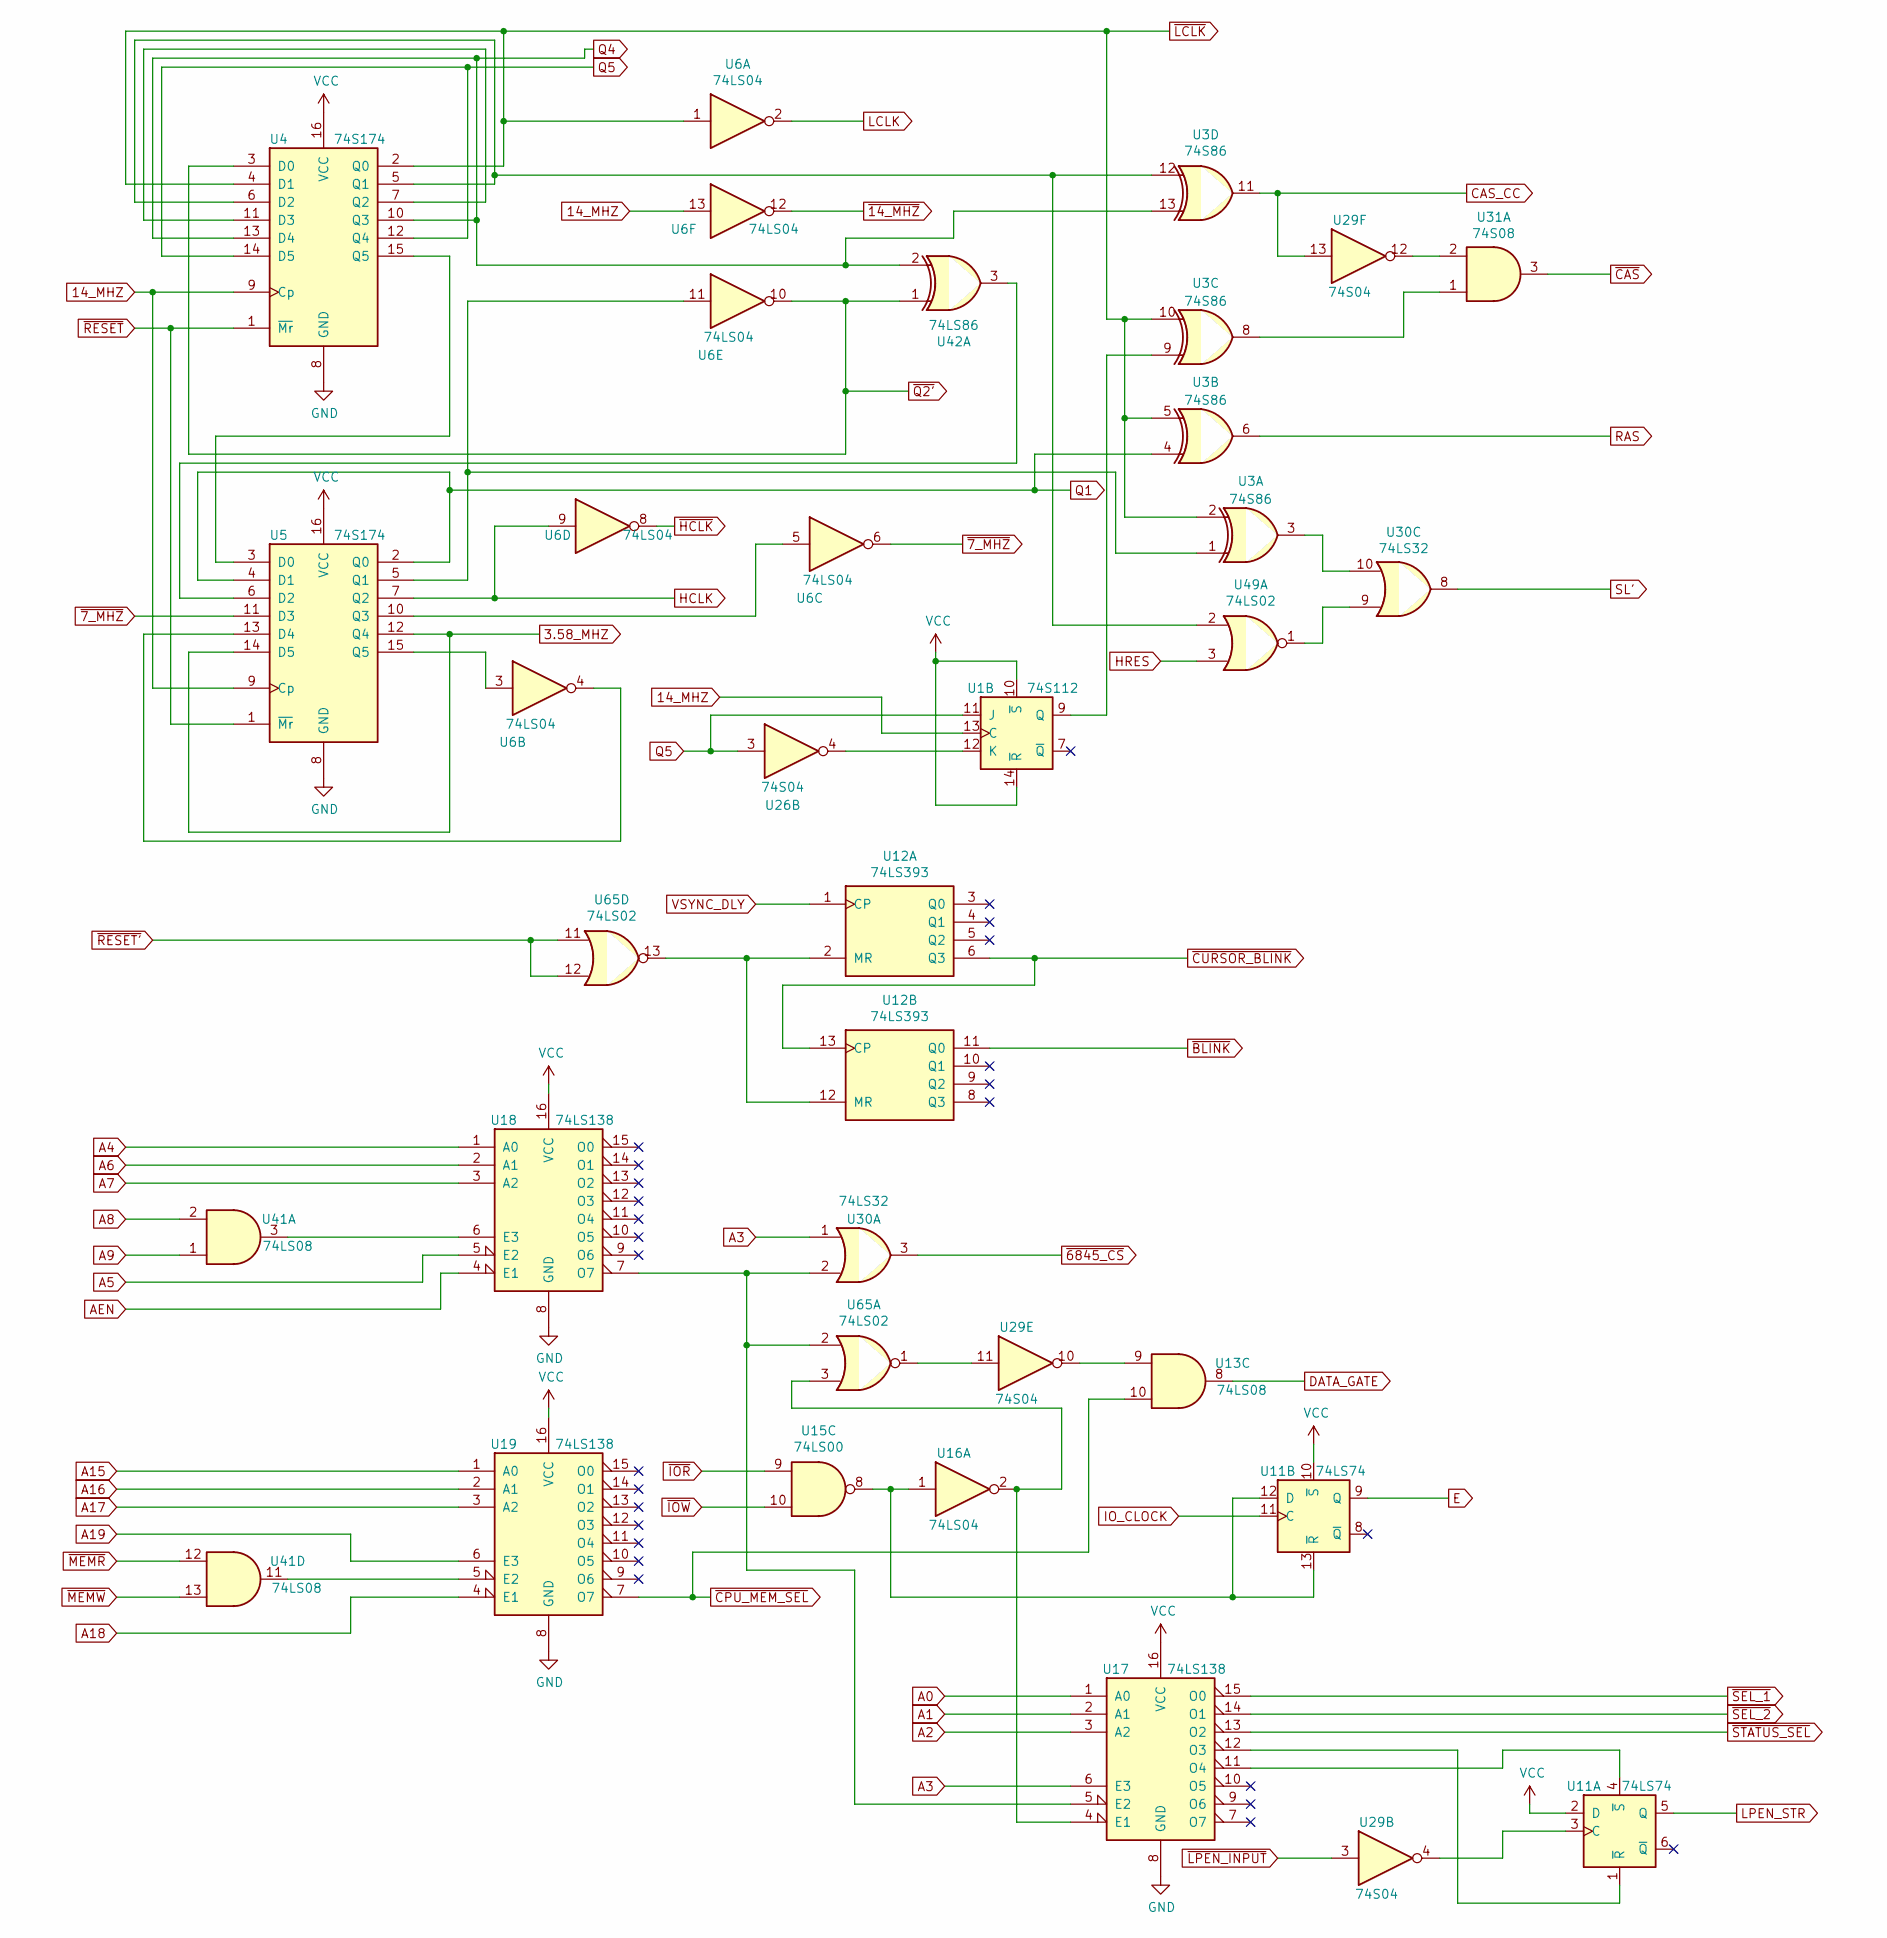
[picture p10: schematic CGA_3_6.kicad_sch]

Parts:
U1: 74S112; DIP-16_W7.62mm_LongPads
U3: 74S86; DIP-14_W7.62mm_LongPads
U4, U5: 74S174; DIP-16_W7.62mm_LongPads
U6, U16: 74LS04; DIP-14_W7.62mm_LongPads
U11: 74LS74; DIP-14_W7.62mm_LongPads
U12: 74LS393; DIP-14_W7.62mm_LongPads
U13, U41: 74LS08; DIP-14_W7.62mm_LongPads
U15: 74LS00; DIP-14_W7.62mm_LongPads
U17, U18, U19: 74LS138; DIP-16_W7.62mm_LongPads
U26, U29: 74S04; DIP-14_W7.62mm_LongPads
U30: 74LS32; DIP-14_W7.62mm_LongPads
U31: 74S08; DIP-14_W7.62mm_LongPads
U42: 74LS86; DIP-14_W7.62mm_LongPads
U49: 74LS02
U65: 74LS02; DIP-14_W7.62mm_LongPads

Connections:
3.58_MHZ: U5.12 (Q4), U5.14 (D5)
14_MHZ: U1.13 (C), U4.9 (Cp), U5.9 (Cp), U6.13
A0: U17.1 (A0)
A1: U17.2 (A1)
A2: U17.3 (A2)
A3: U17.6 (E3), U30.1
A4: U18.1 (A0)
A5: U18.5 (E2)
A6: U18.2 (A1)
A7: U18.3 (A2)
A8: U41.2
A9: U41.1
A15: U19.1 (A0)
A16: U19.2 (A1)
A17: U19.3 (A2)
A18: U19.4 (E1)
A19: U19.6 (E3)
AEN: U18.4 (E1)
CAS_CC: U3.11, U29.13
DATA_GATE: U13.8
E: U11.9 (Q)
GND: U4.8 (GND), U5.8 (GND), U17.8 (GND), U18.8 (GND), U19.8 (GND)
HCLK: U5.7 (Q2), U6.9
HRES: U49.3
IO_CLOCK: U11.11 (C)
LCLK: U6.2
LPEN_STR: U11.5 (Q)
unnamed: U1.9 (Q), U3.9
unnamed: U1.12 (K), U26.4
unnamed: U3.1, U5.5 (Q1), U6.11
unnamed: U3.3, U30.10
unnamed: U3.8, U31.1
unnamed: U3.12, U4.5 (Q1), U4.6 (D2), U49.2
unnamed: U4.7 (Q2), U4.11 (D3)
unnamed: U4.15 (Q5), U5.3 (D0)
unnamed: U5.10 (Q3), U6.5
unnamed: U5.13 (D4), U6.4
unnamed: U5.15 (Q5), U6.3
unnamed: U11.1 (~R), U17.12 (O3)
unnamed: U11.3 (C), U29.4
unnamed: U11.4 (~S), U17.11 (O4)
unnamed: U11.12 (D), U11.13 (~R), U15.8, U16.1
unnamed: U12.2 (MR), U12.12 (MR), U65.13
unnamed: U13.9, U29.10
unnamed: U16.2, U17.4 (E1), U65.3
unnamed: U17.5 (E2), U18.7 (O7), U30.2, U65.2
unnamed: U18.6 (E3), U41.3
unnamed: U19.5 (E2), U41.11
unnamed: U29.11, U65.1
unnamed: U29.12, U31.2
unnamed: U30.9, U49.1
unnamed: U5.6 (D2), U42.3
Q1: U3.4, U5.2 (Q0), U5.4 (D1)
Q4: U3.13, U4.10 (Q3), U4.13 (D4), U42.2
Q5: U1.11 (J), U4.12 (Q4), U4.14 (D5), U26.3
RAS: U3.6
SL': U30.8
VCC: U1.10 (~S), U1.14 (~R), U4.16 (VCC), U5.16 (VCC), U11.2 (D), U11.10 (~S), U17.16 (VCC), U18.16 (VCC), U19.16 (VCC)
VSYNC_DLY: U12.1 (CP)
~7_MHZ: U5.11 (D3), U6.6
~14_MHZ: U6.12
~6845_CS: U30.3
~BLINK: U12.11 (Q0)
~CAS: U31.3
~CPU_MEM_SEL: U13.10, U19.7 (O7)
~CURSOR_BLINK: U12.6 (Q3), U12.13 (CP)
~HCLK: U6.8
~IOR: U15.9
~IOW: U15.10
~LCLK: U3.2, U3.5, U3.10, U4.2 (Q0), U4.4 (D1), U6.1
~LPEN_INPUT: U29.3
~MEMR: U41.12
~MEMW: U41.13
~Q2': U4.3 (D0), U6.10, U42.1
~RESET': U65.11, U65.12
~RESET: U4.1 (~Mr), U5.1 (~Mr)
~SEL_1: U17.15 (O0)
~SEL_2: U17.14 (O1)
~STATUS_SEL: U17.13 (O2)
