hkzlab/CGA_Schematics/CGA_4_6.kicad_sch

## KiCad design CGA_4_6.kicad_sch (2023-10-13)

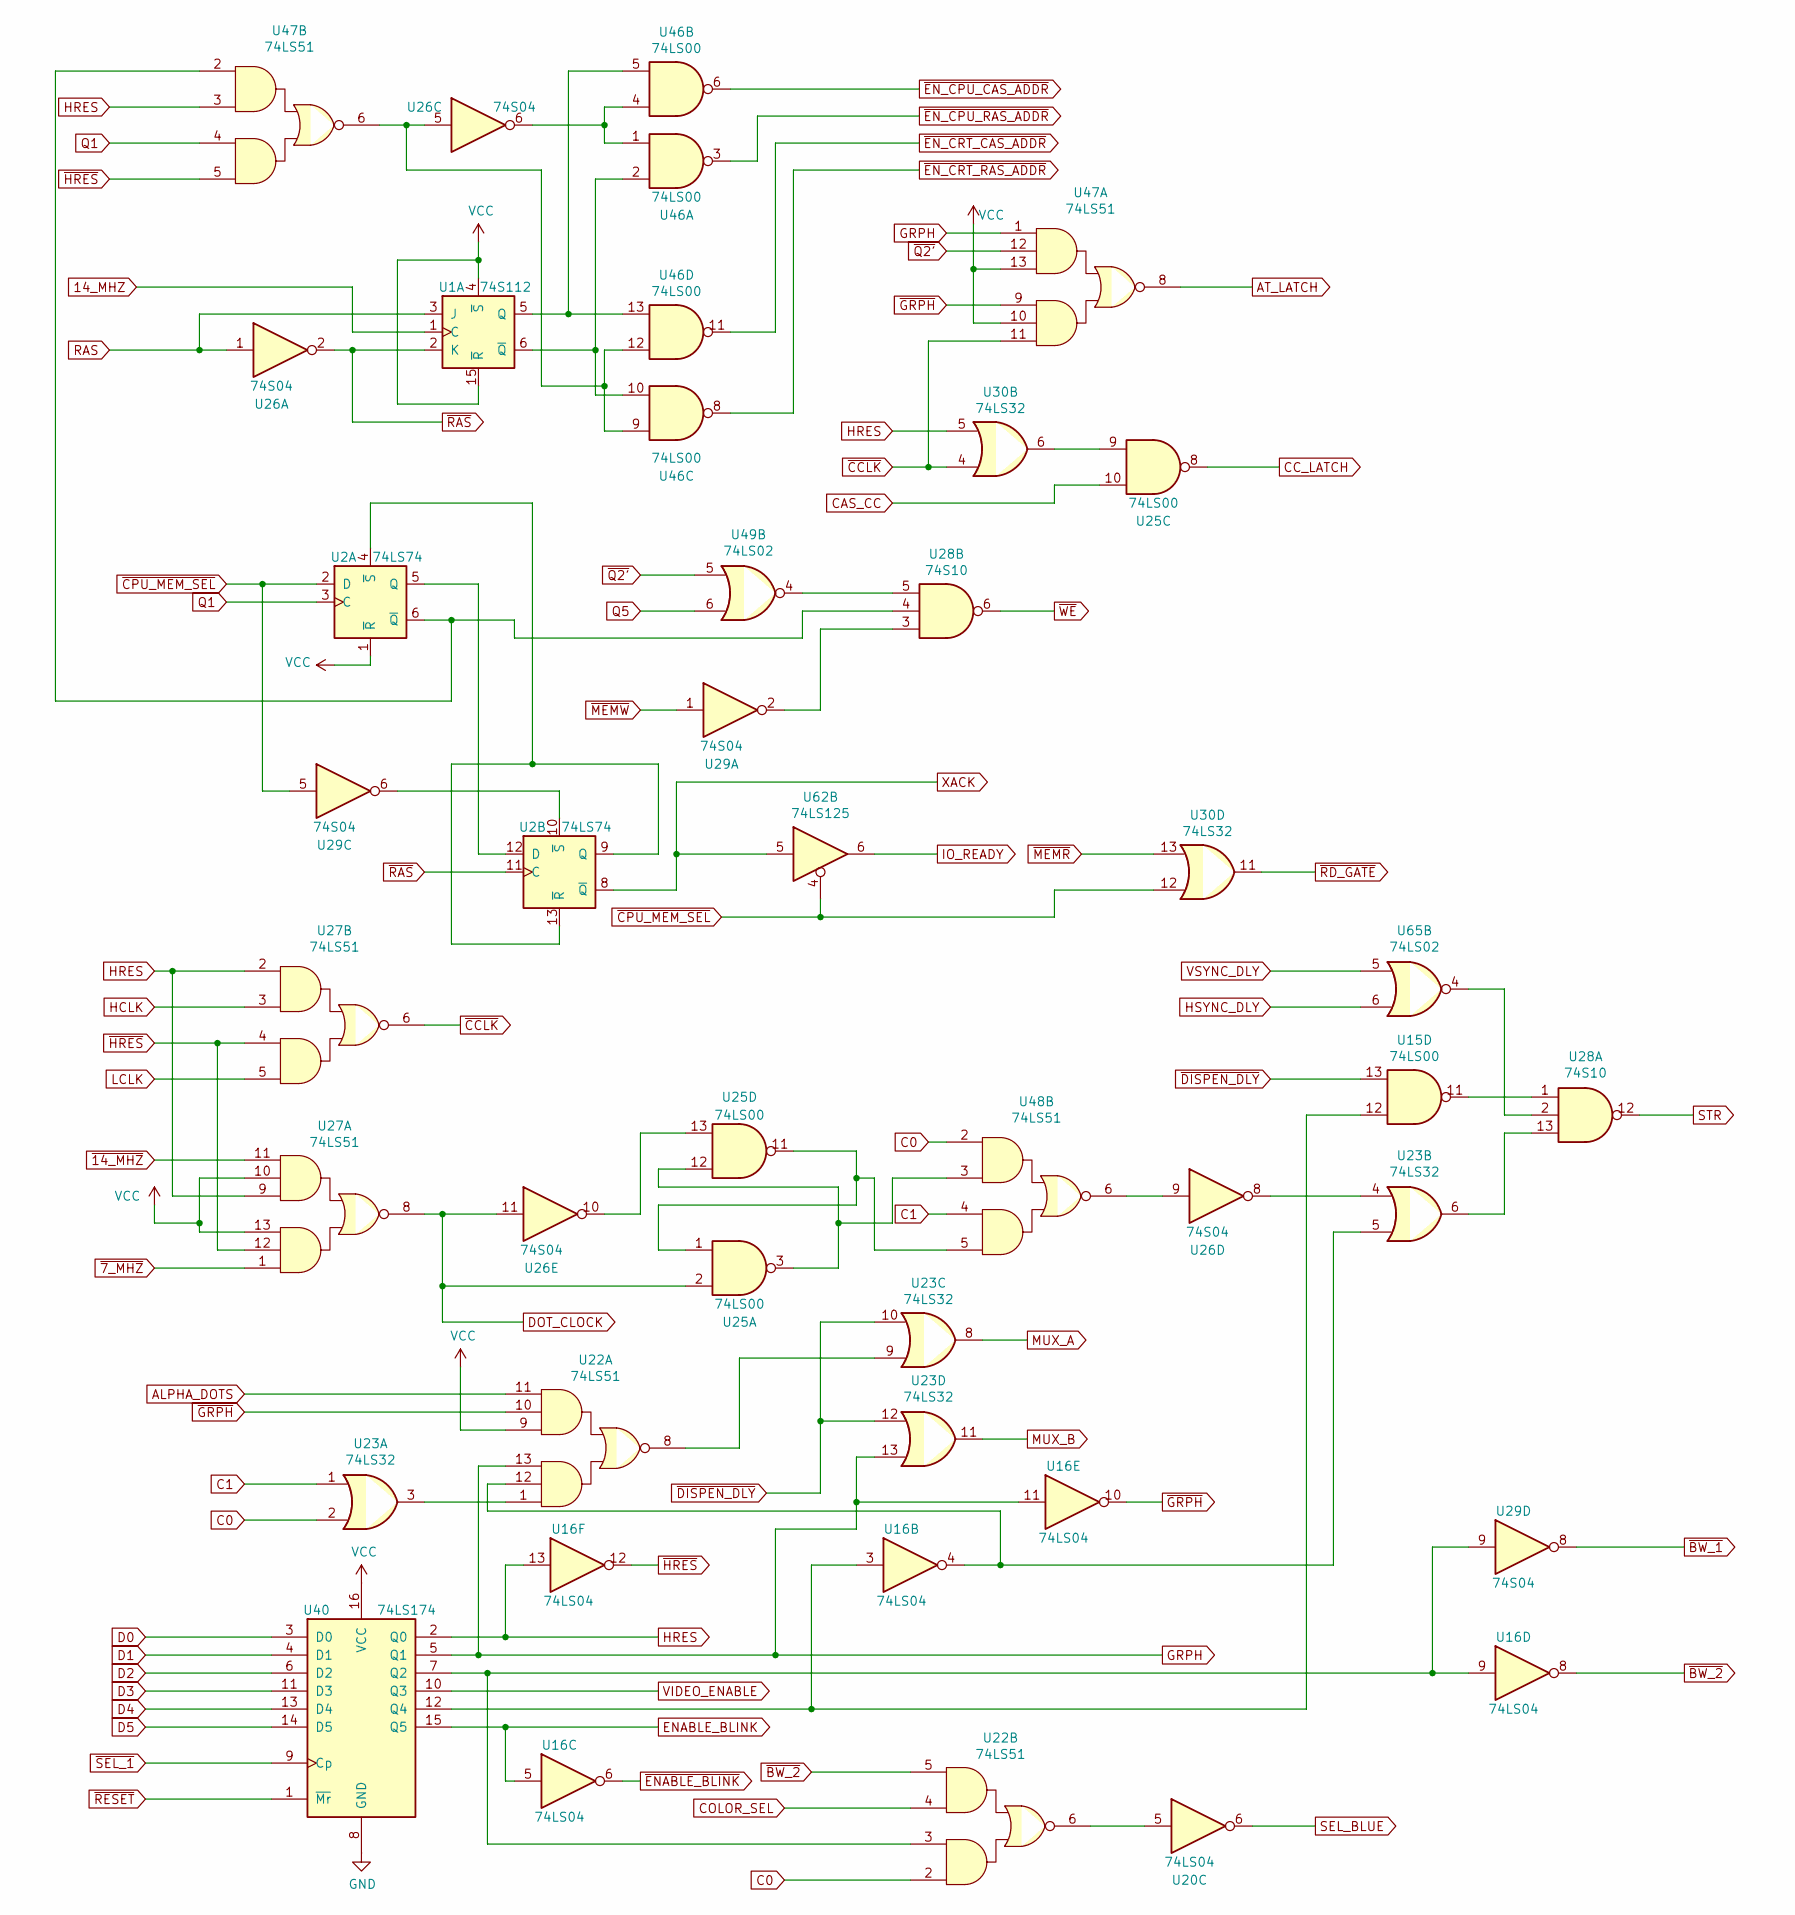
[picture p11: schematic CGA_4_6.kicad_sch]

Parts:
U1: 74S112; DIP-16_W7.62mm_LongPads
U2: 74LS74; DIP-14_W7.62mm_LongPads
U15, U25, U46: 74LS00; DIP-14_W7.62mm_LongPads
U16, U20: 74LS04; DIP-14_W7.62mm_LongPads
U22, U27, U47, U48: 74LS51; DIP-14_W7.62mm_LongPads
U23, U30: 74LS32; DIP-14_W7.62mm_LongPads
U26, U29: 74S04; DIP-14_W7.62mm_LongPads
U28: 74S10; DIP-14_W7.62mm_LongPads
U40: 74LS174; DIP-16_W7.62mm_LongPads
U49: 74LS02
U62: 74LS125; DIP-14_W7.62mm_LongPads
U65: 74LS02; DIP-14_W7.62mm_LongPads

Connections:
14_MHZ: U1.1 (C)
ALPHA_DOTS: U22.11
AT_LATCH: U47.8
C0: U22.2, U23.2, U48.2
C1: U23.1, U48.4
CAS_CC: U25.10
CC_LATCH: U25.8
COLOR_SEL: U22.4
D0: U40.3 (D0)
D1: U40.4 (D1)
D2: U40.6 (D2)
D3: U40.11 (D3)
D4: U40.13 (D4)
D5: U40.14 (D5)
DOT_CLOCK: U25.2, U26.11, U27.8
ENABLE_BLINK: U16.5, U40.15 (Q5)
GND: U40.8 (GND)
GRPH: U16.11, U22.13, U23.13, U40.5 (Q1), U47.1
HCLK: U27.3
HRES: U16.13, U27.2, U27.9, U30.5, U40.2 (Q0), U47.3
HSYNC_DLY: U65.6
IO_READY: U62.6
LCLK: U27.5
MUX_A: U23.8
MUX_B: U23.11
unnamed: U1.5 (Q), U46.5, U46.13
unnamed: U1.6 (~Q), U46.2, U46.10
unnamed: U2.6 (~Q), U28.4, U47.2
unnamed: U2.10 (~S), U29.6
unnamed: U2.5 (Q), U2.12 (D)
unnamed: U2.4 (~S), U2.9 (Q), U2.13 (~R)
unnamed: U15.11, U28.1
unnamed: U15.12, U16.3, U40.12 (Q4)
unnamed: U16.4, U22.12, U23.5
unnamed: U16.9, U22.3, U29.9, U40.7 (Q2)
unnamed: U20.5, U22.6
unnamed: U22.1, U23.3
unnamed: U22.8, U23.9
unnamed: U23.4, U26.8
unnamed: U23.6, U28.13
unnamed: U25.1, U25.11, U48.5
unnamed: U25.9, U30.6
unnamed: U25.3, U25.12, U48.3
unnamed: U25.13, U26.10
unnamed: U26.5, U46.9, U46.12, U47.6
unnamed: U26.6, U46.1, U46.4
unnamed: U26.9, U48.6
unnamed: U28.2, U65.4
unnamed: U28.3, U29.2
unnamed: U28.5, U49.4
Q1: U2.3 (C), U47.4
Q5: U49.6
RAS: U1.3 (J), U26.1
SEL_BLUE: U20.6
STR: U28.12
VCC: U1.4 (~S), U1.15 (~R), U2.1 (~R), U22.9, U27.10, U27.13, U40.16 (VCC), U47.10, U47.13
VIDEO_ENABLE: U40.10 (Q3)
VSYNC_DLY: U65.5
XACK: U2.8 (~Q), U62.5
~7_MHZ: U27.1
~14_MHZ: U27.11
~BW_1: U29.8
~BW_2: U16.8, U22.5
~CCLK: U27.6, U30.4, U47.11
~CPU_MEM_SEL: U2.2 (D), U29.5, U30.12, U62.4
~DISPEN_DLY: U15.13, U23.10, U23.12
~ENABLE_BLINK: U16.6
~EN_CPU_CAS_ADDR: U46.6
~EN_CPU_RAS_ADDR: U46.3
~EN_CRT_CAS_ADDR: U46.11
~EN_CRT_RAS_ADDR: U46.8
~GRPH: U16.10, U22.10, U47.9
~HRES: U16.12, U27.4, U27.12, U47.5
~MEMR: U30.13
~MEMW: U29.1
~Q2': U47.12, U49.5
~RAS: U1.2 (K), U2.11 (C), U26.2
~RD_GATE: U30.11
~RESET: U40.1 (~Mr)
~SEL_1: U40.9 (Cp)
~WE: U28.6
