hkzlab/CGA_Schematics/CGA_5_6.kicad_sch

## KiCad design CGA_5_6.kicad_sch (2023-10-13)

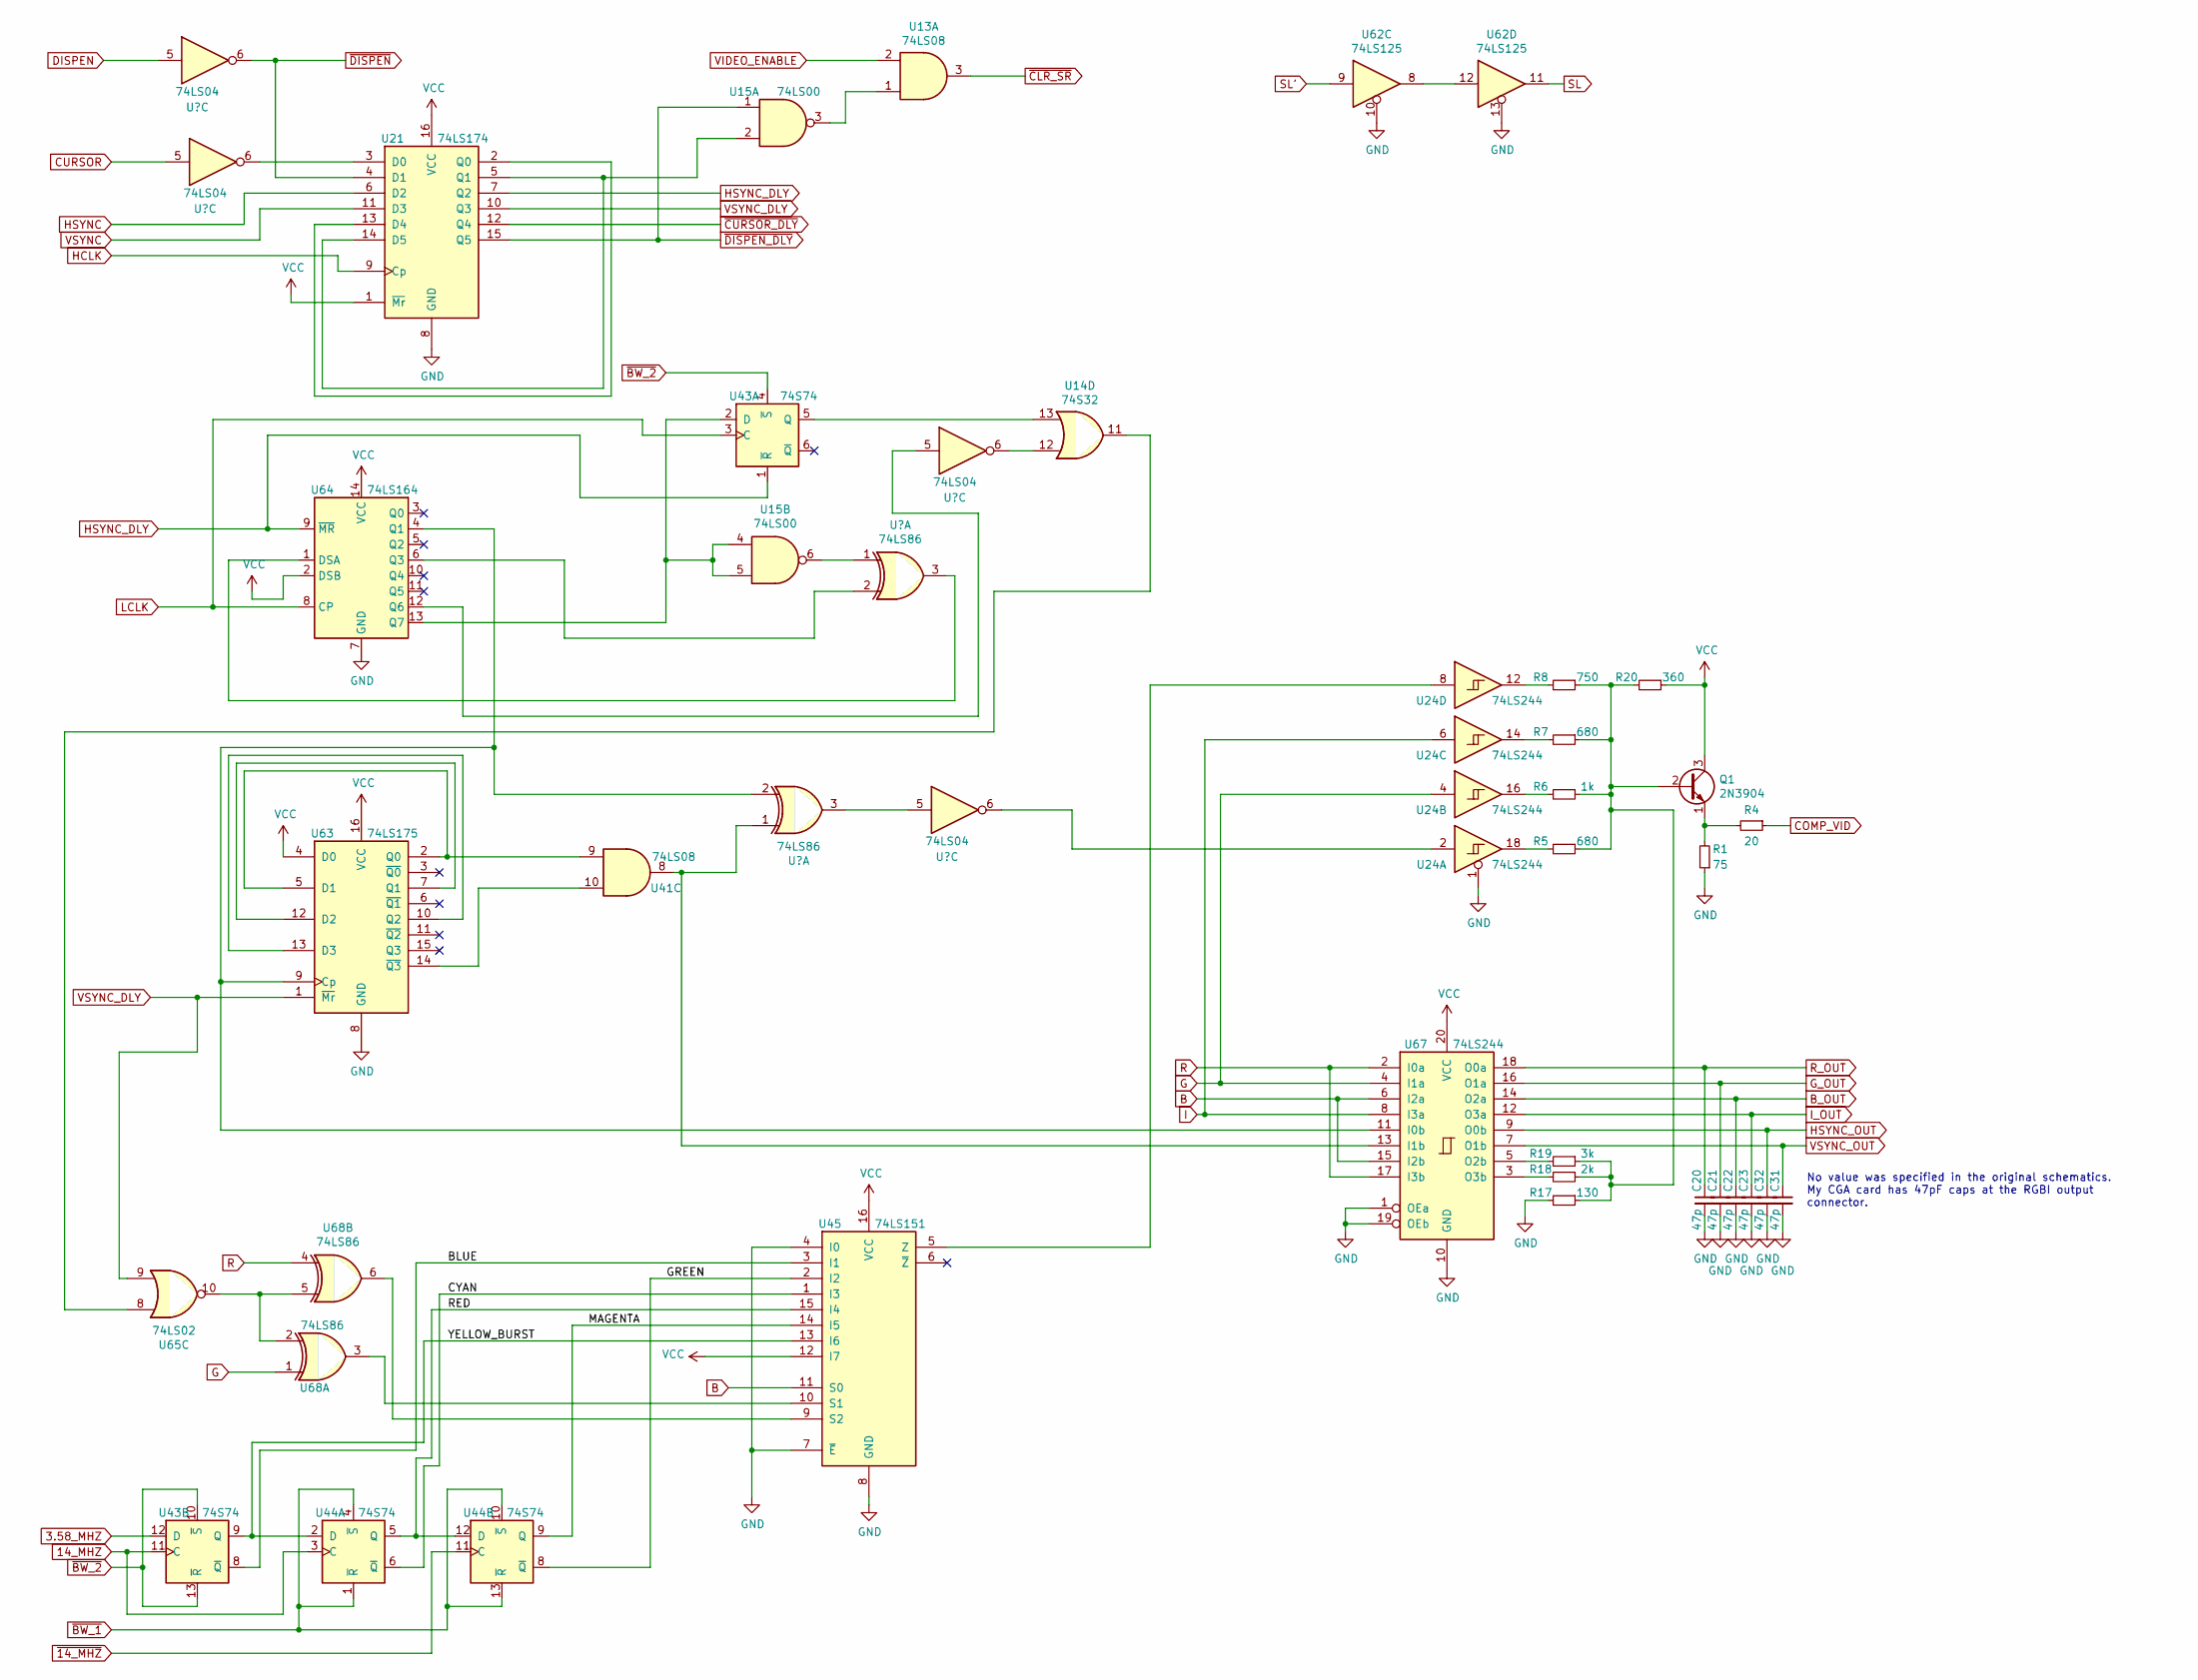
[picture p12: schematic CGA_5_6.kicad_sch]

Parts:
C20, C21, C22, C23, C31, C32: 47p; C_Disc_D4.3mm_W1.9mm_P5.00mm
Q1: 2N3904; TO-92_Inline
R1: 75; R_Axial_DIN0207_L6.3mm_D2.5mm_P10.16mm_Horizontal
R4: 20; R_Axial_DIN0207_L6.3mm_D2.5mm_P10.16mm_Horizontal
R5, R7: 680; R_Axial_DIN0207_L6.3mm_D2.5mm_P10.16mm_Horizontal
R6: 1k; R_Axial_DIN0207_L6.3mm_D2.5mm_P10.16mm_Horizontal
R8: 750; R_Axial_DIN0207_L6.3mm_D2.5mm_P10.16mm_Horizontal
R17: 130; R_Axial_DIN0207_L6.3mm_D2.5mm_P10.16mm_Horizontal
R18: 2k; R_Axial_DIN0207_L6.3mm_D2.5mm_P10.16mm_Horizontal
R19: 3k; R_Axial_DIN0207_L6.3mm_D2.5mm_P10.16mm_Horizontal
R20: 360; R_Axial_DIN0207_L6.3mm_D2.5mm_P10.16mm_Horizontal
U13, U41: 74LS08; DIP-14_W7.62mm_LongPads
U14: 74S32; DIP-14_W7.62mm_LongPads
U15: 74LS00; DIP-14_W7.62mm_LongPads
U20: 74LS04; DIP-14_W7.62mm_LongPads
U21: 74LS174; DIP-16_W7.62mm_LongPads
U24, U67: 74LS244; DIP-20_W7.62mm_LongPads
U42, U68: 74LS86; DIP-14_W7.62mm_LongPads
U43, U44: 74S74; DIP-14_W7.62mm_LongPads
U45: 74LS151; DIP-16_W7.62mm_LongPads
U62: 74LS125; DIP-14_W7.62mm_LongPads
U63: 74LS175; DIP-16_W7.62mm_LongPads
U64: 74LS164; DIP-14_W7.62mm_LongPads
U65: 74LS02; DIP-14_W7.62mm_LongPads

Connections:
3.58_MHZ: U43.12 (D)
14_MHZ: U43.11 (C), U44.3 (C)
B: U45.11 (S0), U67.6 (I2a), U67.15 (I2b)
BLUE: U43.8 (~Q), U45.3 (I1)
B_OUT: C22.1, U67.14 (O2a)
COMP_VID: R4.1
CURSOR: U20.5
CYAN: U44.6 (~Q), U45.1 (I3)
DISPEN: U20.5
G: U24.4, U67.4 (I1a), U68.1
GND: C20.2, C21.2, C22.2, C23.2, C31.2, C32.2, R1.1, R17.2, U21.8 (GND), U24.1, U45.4 (I0), U45.7 (~E), U45.8 (GND), U62.10, U62.13, U63.8 (GND), U64.7 (GND), U67.1 (OEa), U67.10 (GND), U67.19 (OEb)
GREEN: U44.8 (~Q), U45.2 (I2)
G_OUT: C21.1, U67.16 (O1a)
HCLK: U21.9 (Cp)
HSYNC: U21.6 (D2)
HSYNC_DLY: U21.7 (Q2), U43.1 (~R), U64.9 (~MR)
HSYNC_OUT: C32.1, U67.9 (O0b)
I: U24.6, U67.8 (I3a)
I_OUT: C23.1, U67.12 (O3a)
LCLK: U43.3 (C), U64.8 (CP)
MAGENTA: U44.9 (Q), U45.14 (I5)
unnamed: Q1.1 (E), R1.2, R4.2
unnamed: Q1.2 (B), R5.1, R6.1, R7.1, R8.1, R17.1, R18.1, R19.1, R20.2
unnamed: R5.2, U24.18
unnamed: R6.2, U24.16
unnamed: R7.2, U24.14
unnamed: R8.2, U24.12
unnamed: R18.2, U67.3 (O3b)
unnamed: R19.2, U67.5 (O2b)
unnamed: U13.1, U15.3
unnamed: U14.11, U65.8
unnamed: U14.12, U20.6
unnamed: U14.13, U43.5 (Q)
unnamed: U15.2, U21.5 (Q1), U21.14 (D5)
unnamed: U15.4, U15.5, U43.2 (D), U64.13 (Q7)
unnamed: U15.6, U42.1
unnamed: U20.5, U42.3, U64.12 (Q6)
unnamed: U20.6, U21.3 (D0), U24.2
unnamed: U21.2 (Q0), U21.13 (D4)
unnamed: U24.8, U45.5 (Z)
unnamed: U41.8, U42.1, U67.13 (I1b)
unnamed: U41.9, U63.2 (Q0), U63.5 (D1)
unnamed: U41.10, U63.14 (~Q3)
unnamed: U42.2, U63.9 (Cp), U64.4 (Q1), U64.6 (Q3), U67.11 (I0b)
unnamed: U42.3, U64.1 (DSA)
unnamed: U45.9 (S2), U68.6
unnamed: U45.10 (S1), U68.3
unnamed: U62.8, U62.12
unnamed: U63.10 (Q2), U63.13 (D3)
unnamed: U63.7 (Q1), U63.12 (D2)
unnamed: U65.10, U68.2, U68.5
R: U67.2 (I0a), U67.17 (I3b), U68.4
RED: U44.5 (Q), U44.12 (D), U45.15 (I4)
R_OUT: C20.1, U67.18 (O0a)
SL: U62.11
SL': U62.9
VCC: Q1.3 (C), R20.1, U21.1 (~Mr), U21.16 (VCC), U45.12 (I7), U45.16 (VCC), U63.4 (D0), U63.16 (VCC), U64.2 (DSB), U64.14 (VCC), U67.20 (VCC)
VIDEO_ENABLE: U13.2
VSYNC: U21.11 (D3)
VSYNC_DLY: U21.10 (Q3), U63.1 (~Mr), U65.9
VSYNC_OUT: C31.1, U67.7 (O1b)
YELLOW_BURST: U43.9 (Q), U44.2 (D), U45.13 (I6)
~14_MHZ: U44.11 (C)
~BW_1: U44.1 (~R), U44.4 (~S), U44.10 (~S), U44.13 (~R)
~BW_2: U43.4 (~S), U43.10 (~S), U43.13 (~R)
~CLR_SR: U13.3
~CURSOR_DLY: U21.12 (Q4)
~DISPEN_DLY: U15.1, U21.15 (Q5)
~DISPEN: U20.6, U21.4 (D1)

Notes on the sheet:
No value was specified in the original schematics. My CGA card has 47pF caps at the RGBI output connector.
