hkzlab/CGA_Schematics/CGA_6_6.kicad_sch

## KiCad design CGA_6_6.kicad_sch (2023-10-13)

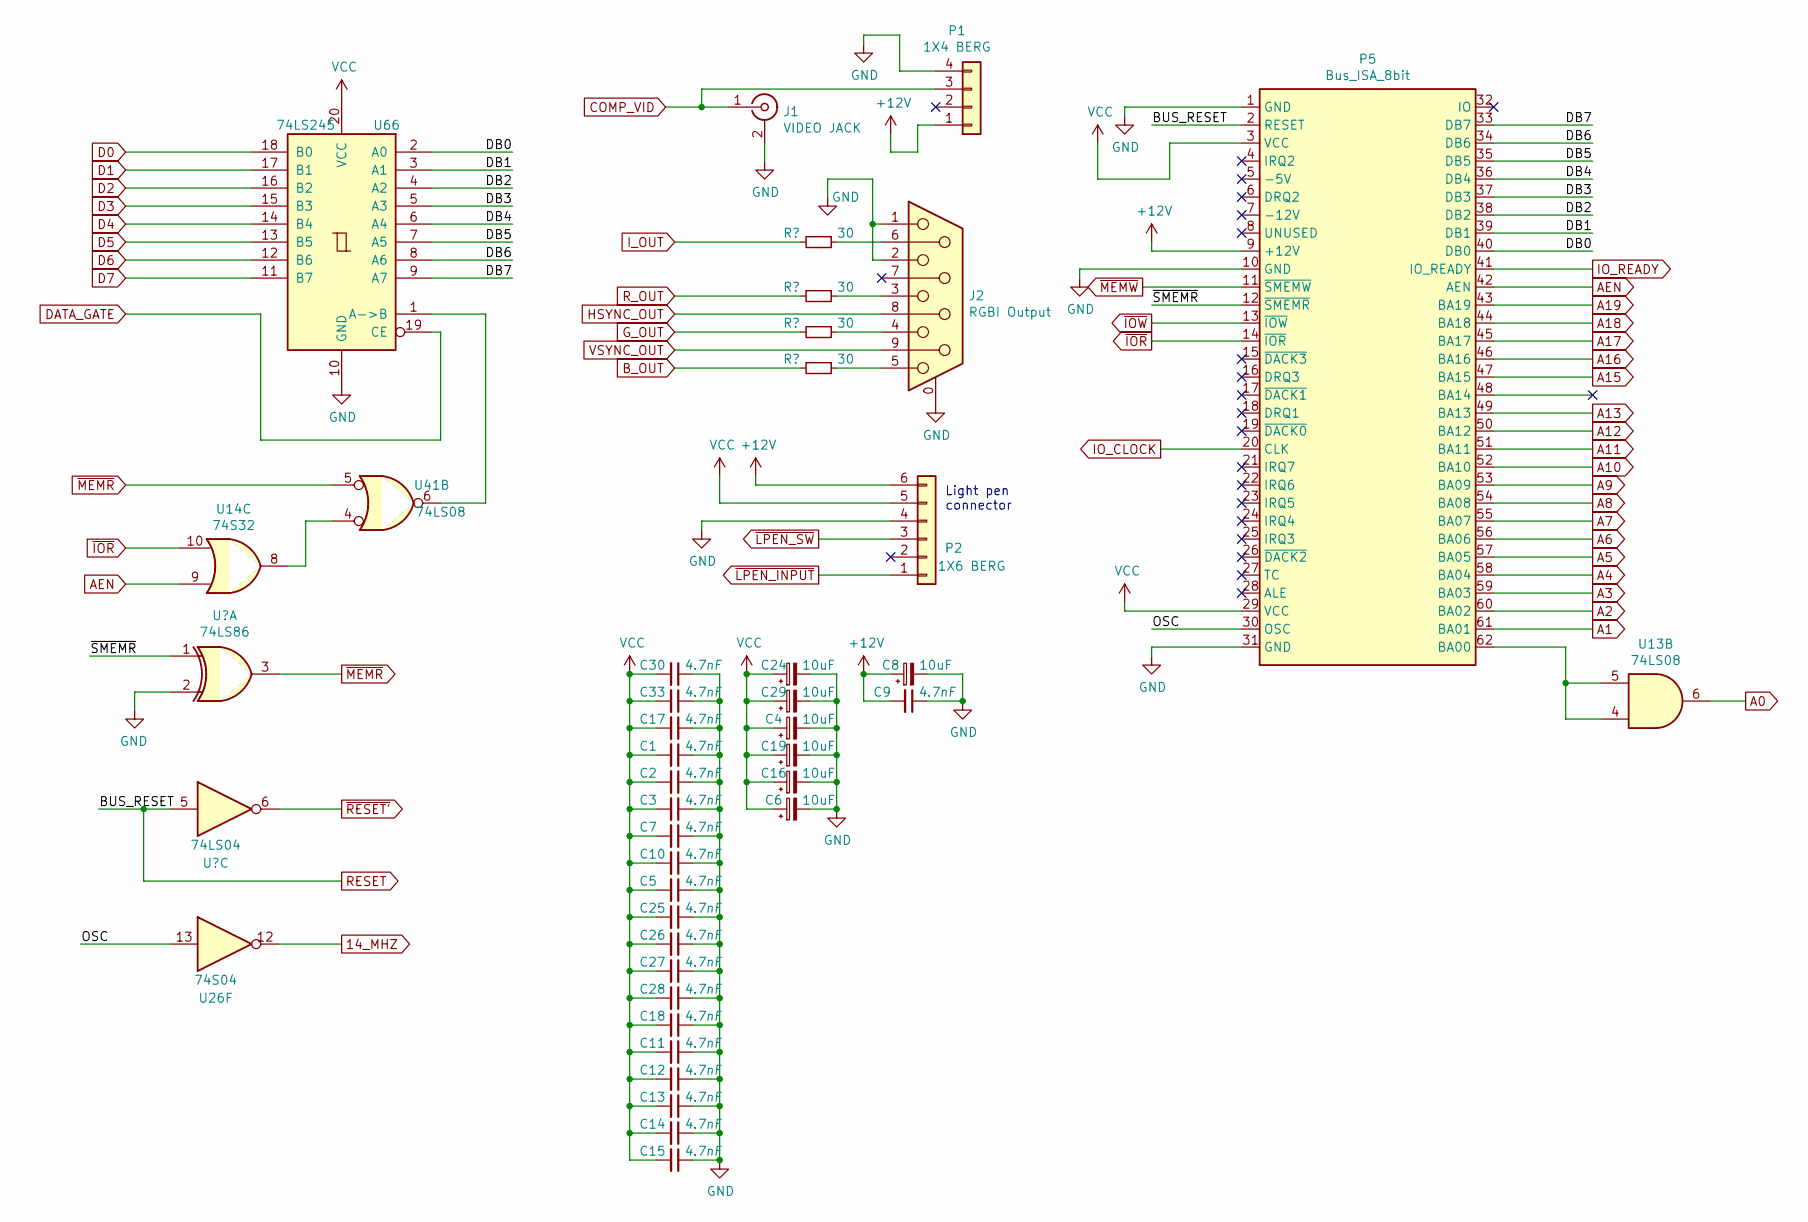
[picture p13: schematic CGA_6_6.kicad_sch]

Parts:
C1, C2, C3, C5, C7, C9, C10, C11, C12, C13, C14, C15, C17, C18, C25, C26, C27, C28, C30, C33: 4.7nF; C_Disc_D4.3mm_W1.9mm_P5.00mm
C4, C6, C8, C16, C19, C24, C29: 10uF; CP_Radial_D8.0mm_P5.00mm
J1: VIDEO JACK
J2: RGBI Output
P1: 1X4 BERG
P2: 1X6 BERG
P5: Bus_ISA_8bit
R11, R12, R13, R14: 30; R_Axial_DIN0207_L6.3mm_D2.5mm_P10.16mm_Horizontal
U13, U41: 74LS08; DIP-14_W7.62mm_LongPads
U14: 74S32; DIP-14_W7.62mm_LongPads
U20: 74LS04; DIP-14_W7.62mm_LongPads
U26: 74S04; DIP-14_W7.62mm_LongPads
U42: 74LS86; DIP-14_W7.62mm_LongPads
U66: 74LS245; DIP-20_W7.62mm_LongPads

Connections:
14_MHZ: U26.12
+12V: C8.1, C9.2, P1.1, P2.6, P5.9 (+12V)
A0: U13.6
A1: P5.61 (BA01)
A2: P5.60 (BA02)
A3: P5.59 (BA03)
A4: P5.58 (BA04)
A5: P5.57 (BA05)
A6: P5.56 (BA06)
A7: P5.55 (BA07)
A8: P5.54 (BA08)
A9: P5.53 (BA09)
A10: P5.52 (BA10)
A11: P5.51 (BA11)
A12: P5.50 (BA12)
A13: P5.49 (BA13)
A15: P5.47 (BA15)
A16: P5.46 (BA16)
A17: P5.45 (BA17)
A18: P5.44 (BA18)
A19: P5.43 (BA19)
AEN: P5.42 (AEN), U14.9
B_OUT: R13.2
COMP_VID: J1.1 (In), P1.3
D0: U66.18 (B0)
D1: U66.17 (B1)
D2: U66.16 (B2)
D3: U66.15 (B3)
D4: U66.14 (B4)
D5: U66.13 (B5)
D6: U66.12 (B6)
D7: U66.11 (B7)
DATA_GATE: U66.19 (CE)
DB0: P5.40 (DB0), U66.2 (A0)
DB1: P5.39 (DB1), U66.3 (A1)
DB2: P5.38 (DB2), U66.4 (A2)
DB3: P5.37 (DB3), U66.5 (A3)
DB4: P5.36 (DB4), U66.6 (A4)
DB5: P5.35 (DB5), U66.7 (A5)
DB6: P5.34 (DB6), U66.8 (A6)
DB7: P5.33 (DB7), U66.9 (A7)
GND: C1.1, C2.1, C3.1, C4.2, C5.1, C6.2, C7.1, C8.2, C9.1, C10.1, C11.1, C12.1, C13.1, C14.1, C15.1, C16.2, C17.1, C18.1, C19.2, C24.2, C25.1, C26.1, C27.1, C28.1, C29.2, C30.1, C33.1, J1.2 (Ext), J2.0 (PAD), J2.1, J2.2, P1.4, P2.4, P5.1 (GND), P5.10 (GND), P5.31 (GND), U42.2, U66.10 (GND)
G_OUT: R12.2
HSYNC_OUT: J2.8
IO_CLOCK: P5.20 (CLK)
IO_READY: P5.41 (IO_READY)
I_OUT: R14.2
unnamed: J2.3, R11.1
unnamed: J2.4, R12.1
unnamed: J2.5, R13.1
unnamed: J2.6, R14.1
unnamed: P5.62 (BA00), U13.4, U13.5
unnamed: U14.8, U41.4
unnamed: U41.6, U66.1 (A->B)
OSC: P5.30 (OSC), U26.13
RESET: P5.2 (RESET), U20.5
R_OUT: R11.2
VCC: C1.2, C2.2, C3.2, C4.1, C5.2, C6.1, C7.2, C10.2, C11.2, C12.2, C13.2, C14.2, C15.2, C16.1, C17.2, C18.2, C19.1, C24.1, C25.2, C26.2, C27.2, C28.2, C29.1, C30.2, C33.2, P2.5, P5.3 (VCC), P5.29 (VCC), U66.20 (VCC)
VSYNC_OUT: J2.9
~IOR: P5.14 (~IOR), U14.10
~IOW: P5.13 (~IOW)
~LPEN_INPUT: P2.1
~LPEN_SW: P2.3
~MEMR: U41.5, U42.3
~MEMW: P5.11 (~SMEMW)
~RESET': U20.6
~SMEMR: P5.12 (~SMEMR), U42.1

Notes on the sheet:
Light pen connector
