hkzlab/CGA_Schematics/ISA_CGA.kicad_sch

## KiCad design ISA_CGA.kicad_sch (2023-10-13)

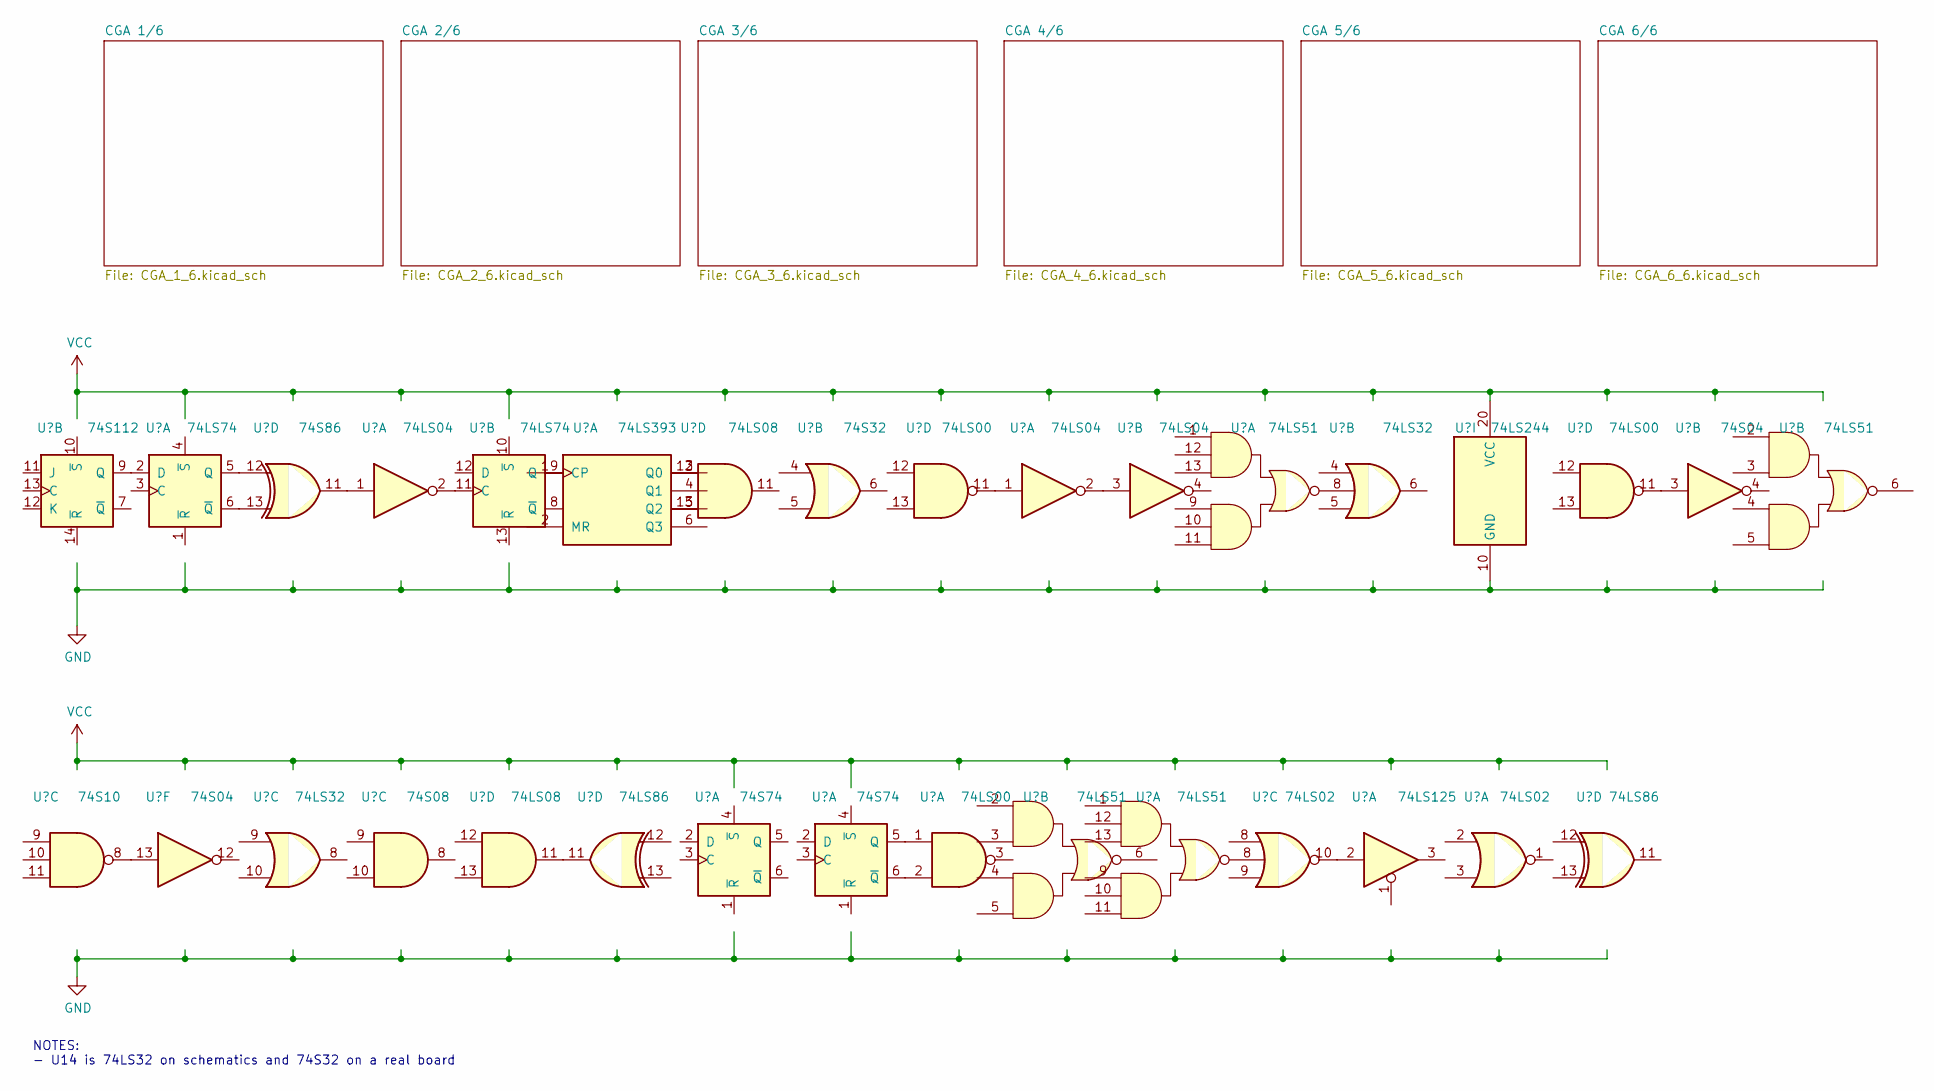
[picture p14: schematic ISA_CGA.kicad_sch]

Parts:
U1: 74S112; DIP-16_W7.62mm_LongPads
U2, U11: 74LS74; DIP-14_W7.62mm_LongPads
U3: 74S86; DIP-14_W7.62mm_LongPads
U6, U16, U20: 74LS04; DIP-14_W7.62mm_LongPads
U12: 74LS393; DIP-14_W7.62mm_LongPads
U13, U41: 74LS08; DIP-14_W7.62mm_LongPads
U14: 74S32; DIP-14_W7.62mm_LongPads
U15, U25, U46: 74LS00; DIP-14_W7.62mm_LongPads
U22, U27, U47, U48: 74LS51; DIP-14_W7.62mm_LongPads
U23, U30: 74LS32; DIP-14_W7.62mm_LongPads
U24: 74LS244; DIP-20_W7.62mm_LongPads
U26, U29: 74S04; DIP-14_W7.62mm_LongPads
U28: 74S10; DIP-14_W7.62mm_LongPads
U31: 74S08; DIP-14_W7.62mm_LongPads
U42, U68: 74LS86; DIP-14_W7.62mm_LongPads
U43, U44: 74S74; DIP-14_W7.62mm_LongPads
U49: 74LS02
U62: 74LS125; DIP-14_W7.62mm_LongPads
U65: 74LS02; DIP-14_W7.62mm_LongPads

Connections:
GND: U24.10 (GND)
unnamed: U1.9 (Q), U2.2 (D)
unnamed: U2.5 (Q), U3.12
unnamed: U2.6 (~Q), U3.13
unnamed: U3.11, U6.1
unnamed: U6.2, U11.11 (C)
unnamed: U15.11, U16.1
unnamed: U16.2, U20.3
unnamed: U25.11, U26.3
unnamed: U28.8, U29.13
unnamed: U41.11, U42.11
unnamed: U44.5 (Q), U46.1
unnamed: U44.6 (~Q), U46.2
unnamed: U49.10, U62.2
VCC: U24.20 (VCC)

Notes on the sheet:
NOTES: - U14 is 74LS32 on schematics and 74S32 on a real board
