hkzlab/CGA_Schematics/(commit log)

2021-04-02 Fix footprint for U30
    [ISA_CGA.sch]
2021-04-02 Change IC type and add note
    [ISA_CGA.sch]
2021-04-02 Fix IC type
    [CGA_1_6.sch, CGA_5_6.sch, CGA_6_6.sch]
2021-04-07 Fix vcc/vss swap for DRAM
    [CGA_1_6.sch]
2021-06-10 U28 is 74S10 and not 74LS10 in original board
    [CGA_1_6.sch, CGA_4_6.sch, ISA_CGA.sch]
2021-11-09 Updated KiCad URL
2023-10-13 Import schematics to KiCad 7
    [CGA_1_6.kicad_sch, CGA_2_6.kicad_sch, CGA_3_6.kicad_sch, CGA_4_6.kicad_sch, CGA_5_6.kicad_sch, CGA_6_6.kicad_sch, ISA_CGA.kicad_sch, ISA_CGA.sch]
